JiaXinTang-xiang/nav_n10/docs/IMU转弯验收-2026-10-08.md

# 时间戳积分与左右转验收（2026-10-08）

## 本次修正

- C++ 底盘和 Nav2 `/spin` 共用 `wheeltec_chassis_cpp/gyro_yaw.hpp`：仅用 `angular_velocity.z` 与相邻消息 `header.stamp` 的差积分，不使用回调到达间隔积分，也不在异常后切回四元数。
- 独立 Python `/imu_spin` 使用相同规则。默认符号 `+1`，死区 `0.03 rad/s`，最大单步角增量 `0.25 rad`。
- 记录消息时间与单调接收时间，任一超过 `0.2 s` 都失效；未来超过 `20 ms`、非有限角速度、零/负时间戳无效。重复和乱序样本不积分、不刷新有效时间。
- 初次收到或间断后需连续两帧才就绪。转弯期间发生积分中断，即使下一周期前恢复也中止该目标、输出零，不自动重试。
- 底盘失去 IMU 时仍沿用轮编码器里程计回退，恢复时重新对齐偏置，避免四元数造成跳变。**这不是整车 IMU 故障急停联锁**；本次失效停车针对 `/spin` 和 `/imu_spin`。
- 非零旋转指令为 `±0.55～±0.60 rad/s`，允许 `0`。近目标脉冲为 `0.24 s` 周期、`0.08 s` 通电，控制频率 `30 Hz`；不会把零速度抬高到最低转速。
- 误差在 `0.045 rad`（约 `2.58°`）内，且陀螺角速度不超过 `0.05 rad/s` 持续 `0.3 s`，才报告完成。惯性越出容差后允许反向修正；超时停车。
- Nav2 插件保留碰撞检查，并检查旋转起始位姿。独立 `/imu_spin` **没有避障**，只能在清空的测试区域使用；脚本检测到 Nav2 或其他独立转弯节点时拒绝启动。
- 当前 Cartographer 导航启动文件不启用速度平滑器，`/spin` 直接输出 `/cmd_vel`。本次未修改键盘布局、串口协议或路径跟踪算法。

此前手动顺时针约 90° 的两次采样：IMU 四元数变化约 −34.44°，odom 变化约 −86.46°。这支持暂时保留 gyro 积分，但不是精密角度标定。gyro 有累计漂移，不能替代长期定位。

**边界：**IMU 消息时间戳仍由驱动生成，并非已实现飞控硬件时钟同步；odom/TF 仍以底盘接收时间发布。本修改不代表解决全部 Cartographer/DDS/TF 延迟问题。

## 已做的软件验证

- 已同步并在 Jetson 编译 `wheeltec_chassis_cpp`、`wheeltec_nav2`，没有在 PC 编译替代部署。
- 共享积分器：正负积分、回调抖动、重复、乱序、断流、过期、未来、NaN、死区通过。
- Jetson 上实际加载 Nav2 C++ `/spin` 插件，以合成 IMU、TF、空代价地图验证；也测试了 Python `/imu_spin`。
- 隔离方式：`ROS_DOMAIN_ID=93`、`ROS_LOCALHOST_ONLY=1`、速度重映射到 `/isolated_spin_cmd`；没有启动测试底盘、没有向实际 `/cmd_vel` 发运动命令。
- 两种实现的 ±90°、零角度、IMU 断流、重复、过期、NaN、取消和超时停车通过；非零输出均在 0.55～0.60 内。C++ 起点障碍拒绝运动、Python 并发目标拒绝通过。
- 合成理想运动复测误差约 1.3～2.3°，**不是实车停止精度**，不包含电机惯性、地面打滑或实际陀螺标定误差。
- 临时测试脚本与日志位于 Jetson `/tmp/verify_gyro_yaw.cpp`、`/tmp/verify_spin_ros.py`、`/tmp/spin_plugin.log`、`/tmp/spin_python.log`，重启可能清除。

## 实车测试（只在 Jetson，暂不开导航）

先关闭 Nav2、自动启动器、键盘控制和旧转弯测试终端；确认车已停止、周围空旷、急停可用。不要仅按 Ctrl+C 关闭 action 客户端来停车：客户端退出不保证取消目标。

### 终端 1：重新启动底盘与传感器，再启动独立转弯

```bash
cd ~/Desktop/nav_n10
source /opt/ros/humble/setup.bash
source ros2_ws/install/setup.bash
export ROS_DOMAIN_ID=0 ROS_LOCALHOST_ONLY=0
export RMW_IMPLEMENTATION=rmw_cyclonedds_cpp
export CYCLONEDDS_URI="file://$PWD/cyclonedds/cyclonedds-jetson.xml"
bash ./robot_bringup.sh
./imu_spin_bringup.sh
```

编译不替换已运行进程的代码，必须先停止所有运动控制再重启。此处不运行定位/导航启动脚本。

### 终端 2：环境与记录

```bash
cd ~/Desktop/nav_n10
source /opt/ros/humble/setup.bash
source ros2_ws/install/setup.bash
export ROS_DOMAIN_ID=0 ROS_LOCALHOST_ONLY=0
export RMW_IMPLEMENTATION=rmw_cyclonedds_cpp
export CYCLONEDDS_URI="file://$PWD/cyclonedds/cyclonedds-jetson.xml"
ros2 topic info /cmd_vel --verbose
```

确认只有 `imu_spin_controller` 一个速度发布节点。若出现键盘、Nav2 等其他发布者，先关闭，不能同时测试。

### 先左转 30°（单独执行）

```bash
ros2 action send_goal /imu_spin nav2_msgs/action/Spin \
  "{target_yaw: 0.523599, time_allowance: {sec: 10, nanosec: 0}}" --feedback
```

确认逆时针、最终 `SUCCEEDED`、完全停住，再单独执行右转：

```bash
ros2 action send_goal /imu_spin nav2_msgs/action/Spin \
  "{target_yaw: -0.523599, time_allowance: {sec: 10, nanosec: 0}}" --feedback
```

两边正常后，将角度分别改为 `1.570796`、`-1.570796` 测 ±90°，时间设为 15 秒；每次结束后确认停车再发下一次，各测三次，禁止连续粘贴多条运动命令。记录目标角、反馈角、日志最终误差、地面标记实际角，以及停车后 1 秒是否继续漂移。

### 取消当前测试（准备好另一个相同环境终端）

```bash
ros2 service call /imu_spin/_action/cancel_goal action_msgs/srv/CancelGoal \
  "{goal_info: {goal_id: {uuid: [0, 0, 0, 0, 0, 0, 0, 0, 0, 0, 0, 0, 0, 0, 0, 0]}, stamp: {sec: 0, nanosec: 0}}}"
```

该命令取消此服务器所有目标；网络异常或车不停止时直接使用硬件急停。

## 放行条件

左右方向正确、指令峰值 ≤0.60、停车后零输出，±90° 各三次实际停止误差建议 ≤3°，不持续漂移或往返振荡。日志积分误差合格但实际角不合格时，继续检查陀螺量纲、安装方向、标定和制动，不开放导航。

通过后关闭独立 `/imu_spin`，再在真实定位、TF、代价地图均正常且无导航目标时单独验收 Nav2 `/spin` 的左右转及碰撞停止；两者不能同时控制底盘。随后才运行 `cartographer_nav2_bringup.sh` 做短距离导航。

当前仍使用位置优先行为树，未启用自动末端转向。没有在本次部署后自动重启底盘或启动车辆；实车验收尚未完成。
