JiaXinTang-xiang/nav_n10/docs/AI交接-底盘直行与SLAM-2026-10-04.md

# 给下一位 AI：STM32 底盘直行控制与 SLAM 交接

更新时间：2026-10-04。本文反映当前工作区代码和本次会话结论。请先读本文，再读源码。

## 1. 用户目标与当前进度

项目根目录：`C:\Users\JXT\Desktop\F407VGT6(QiShi)`。

当前修改的是 `Telemetry framework` 下的 STM32F407 底盘工程，不是同仓库的 `firmware_chassis`，也不是 `firmware_fc`。

用户要让两轮底盘走直，后续用于 SLAM。相同 PWM 时左右电机实际轮速不同是正常现象，不能靠相同 PWM 保证走直。当前采用每轮编码器速度闭环，外加底盘板 ICM45686 的航向角 P 环，纠正直行。

用户反馈：独立的模式 6 角度直行测试已经“比之前直很多”“调得差不多了”。这是用户对模式 6 的实车反馈。最新接入正式上位机控制的版本还没有获得烧录后实车验证，不能把两个版本的验证结果混为一谈。

用户最新要求：正式上位机控制直行时，每段直行要从当时的当前角度开始锁定，不能一直使用某个固定航向。该要求已经实现并完成软件验证。

## 2. 必须保留的约束和用户偏好

- 上位机已经写好；本轮不修改 Jetson/ROS 代码，也不改串口协议。
- 使用底盘板自带 ICM45686 做直行纠偏，不把直行纠偏搬到上位机。
- 底盘轮速控制和航向控制先不要加 Ki。模式 6 和正式直行不增加角速度阻尼。
- 原有模式保留，新实验用独立模式，不要删除模式 2 或覆盖模式 3。
- 用户亲自调过参数，请读当前源码，保留其值，不要把历史初值改回来。
- 硬件实测 `Load(-20,-20)` 是前进。内部接口统一正值前进，只在 `Chassis_OutputRaw()` 中调用 `Load(-left,-right)` 翻转符号。
- 两轮编码器方向修正均为 `-1`，归一化后前进计数应为正。
- 保持 `firmware_fc` 和另一个 F407 提供 ROS IMU 的既有用途。底盘板本地航向控制与上位机 IMU 数据是两件事。
- 工作区中有用户调参和之前 AI 的未提交修改。不要 reset、回滚或覆盖这些修改；不要擅自提交、推送。
- 用中文说明调试方法，给具体观察项，不要只给泛泛的 PID 建议。

注意：“不要加 Ki”指本轮底盘控制器。原 IMU AHRS 内部有积分项，不能因此顺手把姿态算法的 Ki 删掉。

## 3. 主要文件和调用链

下面路径均相对于项目根目录：

| 文件 | 作用 |
|---|---|
| `Telemetry framework/Appliaction/Chassis_task.c/.h` | 左右轮控制、直行外环、里程计、测试模式、OLED |
| `Telemetry framework/Appliaction/Chassis_protocol.c/.h` | 上位机速度协议、超时停车、里程计发送 |
| `Telemetry framework/Appliaction/Timer_task.c` | TIM6 时基、200 Hz 底盘控制、50 Hz 里程计发送 |
| `Telemetry framework/Core/Src/main.c` | IMU 更新、按键切换模式、OLED 页面 |
| `Telemetry framework/Device/Hardware/encoder.c/.h` | 编码器捕获、方向归一化、距离换算 |
| `Telemetry framework/Device/IMU/ICM45686/IMU_45686.c/.h` | IMU 解算和发布 yaw/gz 供底盘读取 |
| `Telemetry framework/Algorithm/pid.c` | 工程原有 PID |
| `Telemetry framework/MDK-ARM/Telemetry framework.uvprojx` | Keil 工程 |

TIM6 为 100 us 时基，`Chassis_Update()` 每 5 ms 执行一次。该函数先调用 `Host_ApplyPendingCommand()`，再更新编码器反馈、航向误差、里程计和轮速输出。

主循环调用 `IMU_getYawPitchRoll(ypr)`；IMU 驱动发布最近的 yaw（度）和已扣零偏的 gz（rad/s）。底盘定时器中只调用 getter 读取缓存，不在中断中访问 IMU SPI。

## 4. 当前调好的参数：以源码为准

`Chassis_task.c` 当前值：

```cpp
static const fp32 s_pid_left_param[3]  = {70.0f, 0.0f, 5.0f};
static const fp32 s_pid_right_param[3] = {70.0f, 0.0f, 5.0f};
#define CHASSIS_LEFT_FF_PWM_PER_MPS   95.0f
#define CHASSIS_RIGHT_FF_PWM_PER_MPS  70.0f
#define CHASSIS_FF_STATIC_PWM          2.0f
#define CHASSIS_SPEED_LPF              0.1f
#define CHASSIS_ANGLE_YAW_SIGN        (-1.0f)
#define CHASSIS_ANGLE_KP                2.5f
#define CHASSIS_ANGLE_CORR_MAX          0.35f
#define CHASSIS_ANGLE_DEADBAND_DEG      0.30f
```

用户之前提过角度 Kp=2.0，现在源码是 2.5；不要按旧消息改回 2.0。轮速 Kp 现在是 70，不要照旧 `HANDOFF.md` 中的 100 恢复。

每轮速度控制为“独立前馈 + PD”，Ki=0：

```text
PWM = 该轮前馈系数 × 修正后的目标轮速
    + 目标方向 × 静摩擦前馈
    + PID_calc(反馈轮速, 修正后的目标轮速)
```

计算结果限制在 ±100 后转换为整数 PWM。

模式 3 的旧 gz 外环保留，参数为：Z_SIGN=+1，LPF=0.15，Kp=3.0，纠偏限幅 ±0.35 rad/s，死区 0.01 rad/s。这套参数不用于最新正式上位机直行。

`encoder.h` 当前机械参数：轮径 0.065 m，轮距 0.158 m，编码器 13 线，减速比 30，A 相双边沿 2 倍频，理论 780 count/轮子一圈。左右距离修正系数 `ENC_LEFT_DISTANCE_SCALE`、`ENC_RIGHT_DISTANCE_SCALE` 目前均为 1.0000，通过 `Encoder_GetMetersPerCount(id)` 同时用于速度和里程计。

## 5. 航向角直行怎么纠偏

航向角统一成逆时针为正。原 AHRS yaw 的输出带负号，因此使用当前 `CHASSIS_ANGLE_YAW_SIGN=-1` 转换；最终符号以实车左转时显示的当前角 N 增大为判据。

```text
now  = WrapPi(YAW_SIGN × IMU_GetYawDeg() × pi/180)
error = WrapPi(reference - now)
corr_w = clamp(Kp × error, -0.35, +0.35)  // rad/s
```

误差绝对值 ≤0.30° 时纠偏量为 0。

```text
左轮控制目标 = 原左轮目标 - 轮距/2 × corr_w
右轮控制目标 = 原右轮目标 + 轮距/2 × corr_w
```

例如车体向左偏，当前角增大，误差为负，纠偏角速度为负，左轮目标相对增加、右轮目标相对减小，产生向右纠偏。不要把这一关系解释反了。

`WrapPi` 处理 ±180° 跨界，取最短角度差。此环保持朝向，不能消除已经发生的横向位移；六轴 IMU 的 yaw 也会随时间漂移，不能宣称具有绝对航向或无限时长直线保证。

## 6. 最新完成：正式上位机每段直行锁当前角

入口为 `Chassis_SetTwist(v_mps,w_radps)`。状态为 `s_angle_hold_en`、`s_host_straight_dir`（0 无正式直行段，+1 前进，-1 后退），参考角为 `s_angle_ref_rad`。

判定直行：`abs(v)>=0.001 m/s` 且 `abs(w)<0.0005 rad/s`。串口角速度的分辨率是 0.001 rad/s，所以协议中任何非零角速度都退出直行锁角，避免吞掉导航控制器的小转向。

| 场景 | 当前行为 |
|---|---|
| 新的一段直行 | 捕获当时 IMU yaw 为参考角 |
| 持续重复发送直行指令 | 保留原参考角，不每帧重置 |
| 同方向直行改变线速度 | 保留原参考角 |
| 非零角速度，包括很小的转向 | 关闭角度环和旧 gz 外环，执行上位机差速指令 |
| 零速度零角速度 | `Chassis_Stop()`，清除锁角状态 |
| 250 ms 通信超时 | 停车并清除锁角状态 |
| 直行前后换向 | 重新捕获当前角 |
| 转弯或停车后再次直行 | 重新捕获当前角 |
| 模式 6 切到正式直行 | 正式指令重新捕获，不沿用测试参考角 |

实现注意：`Chassis_SetWheelSpeed()` 会清除角度状态，因此 `SetTwist()` 在调用它之前保存是否需要保留参考角，调用后恢复正式直行状态。不能删掉这一步导致持续直行每次都重锁角。

`Chassis_Stop()`、`Chassis_Brake()`、开环 PWM 接口均清除正式直行状态。正式 `SetTwist` 全程不使用模式 3 的 gz 阻尼。

## 7. 测试模式与 OLED

USERKEY 短按按 0→1→2→3→4→5→6→0 切换，共七个模式。

| 模式 | 当前作用 |
|---|---|
| 0 | 默认编码器/里程计显示；正式角度锁定活动时改显示 AH 航向页 |
| 1 | 开环，等效底层 `Load(-20,-20)` |
| 2 | 两轮目标 0.2 m/s，仅编码器速度环，明确关闭 IMU 外环 |
| 3 | 两轮目标 0.2 m/s，保留旧 gz 纠偏用于对比 |
| 4 | 原有编码器电气自检，主动操作编码器引脚 |
| 5 | gz、滤波值、旧 gz 纠偏量、旧外环使能显示 |
| 6 | 独立角度直行测试，启动时捕获 yaw，目标 0.2 m/s |

模式 1/2/3/6 会驱动电机，切离这些模式调用 `Chassis_TestStop()`。

角度页第一行：模式 6 为 `A6 T/N:目标,当前`；正式直行为 `AH T/N:目标,当前`。角度整数除以 10 得到度。

第二行 `E/C`：误差除以 10 为度，纠偏量 C 除以 1000 为 rad/s。第三行 `act` 为滤波后的左右实际轮速 mm/s；第四行为归一化 PWM。

OLED 各页面画图前调用 `OLED_operate_gram(PEN_CLEAR)` 清 framebuffer，再画完整页，最后一次 `OLED_refresh_gram()`，解决前一页面字符残留。不要再改成先清屏刷新、再画再刷新造成闪烁。MicroLIB 不支持这里的 `%f`，显示用缩放整数。

模式 5 写着 raw gz，但 getter 实际发布的是扣过零偏的 gz，不是传感器原始量。

正式控制调试保持模式 0；按键测试与上位机指令没有新增仲裁，上位机指令仍能覆盖本地测试。不要同时运行本地电机测试和上位机运动控制后据此判断 PID。

## 8. 串口协议保持不变

USART2 PD5/PD6，115200。速度帧 7 字节：

```text
BB v_hi v_lo w_hi w_lo checksum 55
```

v、w 均为有符号 int16 大端，单位分别 mm/s、mrad/s；checksum 为第 1～4 数据字节求和取低 8 位。合法帧通过缓存由 200 Hz 底盘任务应用，250 ms 无合法速度帧自动停车。

里程计 50 Hz 发 15 字节：`CC` + x_mm/y_mm/theta_rad 三个 float32 小端 + 数据字节求和校验 + `55`。

最新改动没有修改协议，也没有把 IMU yaw 塞进里程计 theta；当前 theta 仍由编码器差速积分产生。

## 9. 已做验证与尚未验证的界限

已通过：

- ARM GCC 工具链以 C++、Cortex-M4 硬浮点配置对 `Chassis_task.c`、`Chassis_protocol.c`、`main.c`、`IMU_45686.c` 做语法检查。
- 从当前生产源码提取函数，使用主机 g++ 临时测试协议及状态切换：重复直行、同方向变速、停车、转弯、前后换向、250 ms 超时、测试模式进入正式控制、刹车和开环清状态。
- 同一临时测试验证角度纠偏正负号、±180° 跨界、死区、纠偏限幅，以及模式 2/3/6 外环互相独立。
- `git diff --check` 通过。

已有 `M_PI`、`__FILE_NAME__` 宏重复定义警告；此次语法检查无错误。没有执行完整 Keil 链接，没有烧录，也没有替用户完成地面 SLAM 验证。

工具位置：

```text
E:\STM32_Tools\ST\STM32CubeCLT_1.18.0\GNU-tools-for-STM32\bin\arm-none-eabi-g++.exe
E:\sofa\mingw\bin\g++.exe
```

工程 `.c` 在现有 Keil 配置中按 C++ 编译，验证时不要误用纯 C 模式。临时主机测试为 `%TEMP%\chassis_host_heading_test.cpp/.exe`；跨平台交接时不假设这些临时文件存在。

## 10. 下一步优先级

1. 请用户重新编译烧录最新正式控制版本，在模式 0 下用上位机执行直行→停车→转 90°→再次直行。观察第一段 T 固定，后一段 T 捕获转弯后的当前角。验证持续变速不重锁角、倒车重新锁角，以及停止发包超时停车。
2. 三角函数近似已修复；烧录后继续做前进、后退和转角标定，确认转弯后的坐标积分。
3. 实测前进/后退 1～2 m，对比编码器左右距离和里程计；标定轮周长/左右距离系数。以源码及新测量为准，不要把旧文档中历史测量当成本次验证。
4. 实测左右旋转 90°、180°，检查角度符号与有效轮距。检查转弯后直走，x/y 是否符合方向。360° 应累计展开角度或积分增量，当前 theta 会 WrapPi，不能拿最后的 theta=0 就宣称转满一圈的精度正确。
5. 通过后低速跑 SLAM，检查墙面重影、转弯后对齐、闭环后的地图形状。保持现有上位机架构，定位问题后再决定是否需要改代码。

建议先维持已经调好的 Kp；不要用继续增大角度 Kp 去掩盖编码器标定或里程计数学错误。走直只验证了部分底盘行为，并不等于已经满足 SLAM 的全部要求。

## 11. 待核查问题

### 已修复：里程计三角函数近似

`Chassis_task.c` 的 `SinCosApprox()` 原公式中：

```cpp
num = x * (CHASSIS_PI - x);
*s = sgn * (4.0f * num) / (CHASSIS_PI * CHASSIS_PI + num);
*c = (CHASSIS_PI * CHASSIS_PI - 4.0f * num)
     / (CHASSIS_PI * CHASSIS_PI + num);
```

当角度为 pi 时，num=0，算出 cos=+1，实际应为 -1；当前公式无法得到正确的负 cos。sin 公式也不是正确的 Bhaskara I 表达式，pi/2 时算得 0.8，而实际为 1。源码“误差 <0.2%”的注释不能相信。

这意味着直线朝向 0 时可能看似正常，转弯后 x/y 明显错误。该函数现已改为正确的 Bhaskara I 正弦近似，并通过象限对称关系计算余弦，不依赖 `libm`。烧录后仍需用 0、±pi/2、pi 和整圈运动做实车里程计验证。

### 编码器 A 相捕获解码仍需核查

只在 A 相双边沿触发中断，但 `Encoder_CaptureIRQ()` 当前用相邻 AB 四状态转换判断方向。A 相两次中断之间 B 相也可能变化，不能直接套用每个 AB 边沿均采样的假设。需要结合波形和手转轮子计数验证；本轮没有重新设计解码。

`Encoder_TakeIsrCount()` 目前取走并清零的是 `s_raw_count`，不是独立边沿计数器，可能污染正常里程计增量。现有活动页面未调用 `Chassis_DebugDisplayIsr()`，不要未修这个问题就把该诊断页接回运行路径。

### IMU 零偏和采样时序

当前零偏更新根据 gyro 低方差和计数条件判断，恒定转动也可能低方差，可能误当静止并更新偏置。若转弯或长时间运行后 yaw 异常，检查这里。

IMU 解算在包含 OLED 刷新的主循环内，尚无独立固定采样调度、数据新鲜度检测或故障退出锁角逻辑。若角度更新慢或数据卡住，需要测采样周期和 OLED 开销，不能仅依据底盘控制任务 200 Hz 就认为 IMU 也在 200 Hz 更新。

上述后两类是需要定位的风险，不是本次实车证实的新故障。不要不看数据就大范围重构。

## 12. 文档冲突与接手提醒

根目录旧 `HANDOFF.md` 仍有架构与历史调试资料，但其中“当前参数”“全部验证通过”“底盘 IMU 不参与”等文字已经不能代表最新状态。阅读顺序：当前源码 → 本文 → 旧文档。

接手后先检查 `git status` 和当前参数。用户这轮只是让生成交接说明，未请求继续修复第 11 节问题；如果用户要求继续推进 SLAM，再根据这些线索开展工作。

可以直接向用户说明：最新完成了正式直行按段锁当前航向，软件测试通过，下一步烧录验证控制切换，再修/核查里程计数学并做距离、转角标定。不要宣称已经完成 SLAM 实车验证。
