JiaXinTang-xiang/nav_n10/firmware_fc/ANO_LX_FC_ROS/Doc/note.txt

APB1   42m
APB2   84m

TIMx clk = APBx *2

中断优先级：

第0组：所有4位用于指定响应优先级；
第1组：最高1位用于指定抢占式优先级，最低3位用于指定响应优先级；
第2组：最高2位用于指定抢占式优先级，最低2位用于指定响应优先级；
第3组：最高3位用于指定抢占式优先级，最低1位用于指定响应优先级；
第4组：所有4位用于指定抢占式优先级。
|先抢占，再响应|
1）如果指定的抢占式优先级别或响应优先级别超出了选定的优先级分组所限定的范围，将可能得到意想不到的结果；
2）抢占式优先级别相同的中断源之间没有嵌套关系；
3）如果某个中断源被指定为某个抢占式优先级别，又没有其它中断源处于同一个抢占式优先级别，则可以为这个中断源指定任意有效的响应优先级别。

更新记录：
20250427  调整代码结构 
          添加PWM5 6 7 8 初始化控制舵机代码
          验证PWM控制电机成功
          在Drv_AnoOF.c文件中可以选择使用V3或V4版本

20250429  添加PID控制（未验证）
