JiaXinTang-xiang/nav_n10/example/ROS_SLAM/IMU_STL/陀螺仪转接件.STL

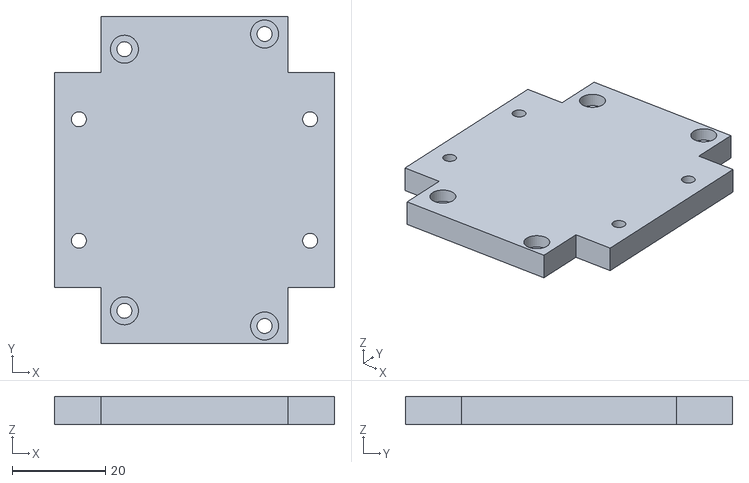
[picture p10: CAD file, 2026-10-04]
example/ROS_SLAM/IMU_STL/陀螺仪转接件.STL
60.0 x 70.0 x 6.00
