JiaXinTang-xiang/nav_n10/example/ROS_SLAM/urdf_mac_ws/src/urdf_show/meshes/imu_Link.STL

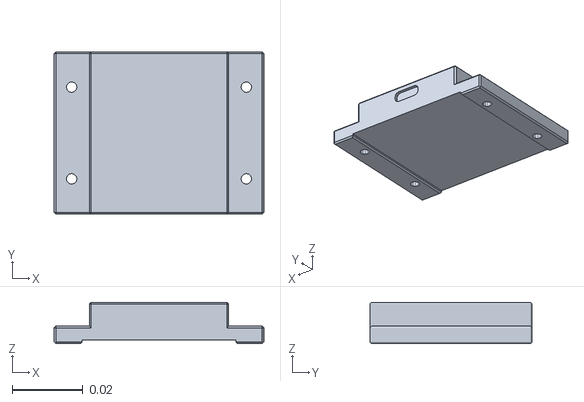
[picture p11: CAD file, 2026-10-04]
example/ROS_SLAM/urdf_mac_ws/src/urdf_show/meshes/imu_Link.STL
0.0595 x 0.046 x 0.0117
