JiaXinTang-xiang/nav_n10/example/ROS_SLAM/urdf_mac_ws/src/urdf_show/meshes/wheel_lf_Link.STL

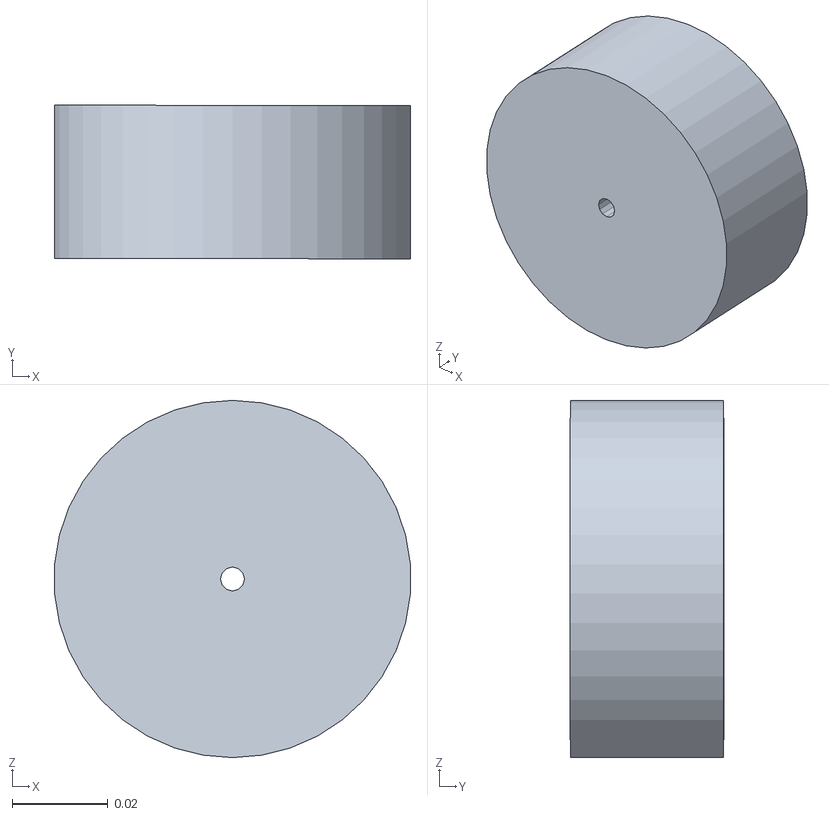
[picture p12: CAD file, 2026-10-04]
example/ROS_SLAM/urdf_mac_ws/src/urdf_show/meshes/wheel_lf_Link.STL
0.0742 x 0.032 x 0.0745
