JiaXinTang-xiang/nav_n10/example/ROS_SLAM/urdf_mac_ws/src/urdf_show/meshes/lidar_Link.STL

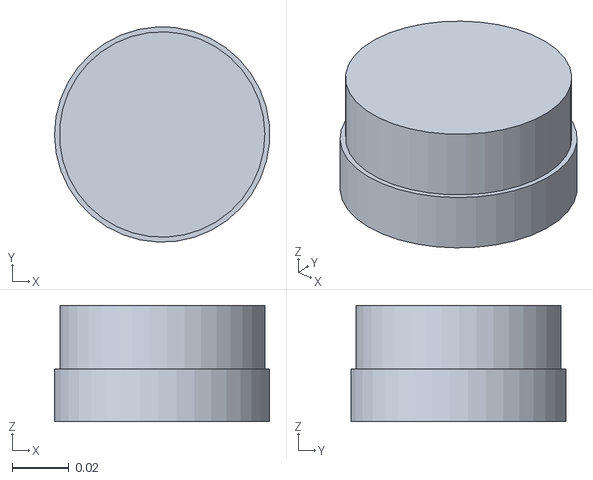
[picture p13: CAD file, 2026-10-04]
example/ROS_SLAM/urdf_mac_ws/src/urdf_show/meshes/lidar_Link.STL
0.0759 x 0.0759 x 0.041
