JiaXinTang-xiang/nav_n10/example/ROS_SLAM/urdf_mac_ws/src/urdf_show/meshes/base_link.STL

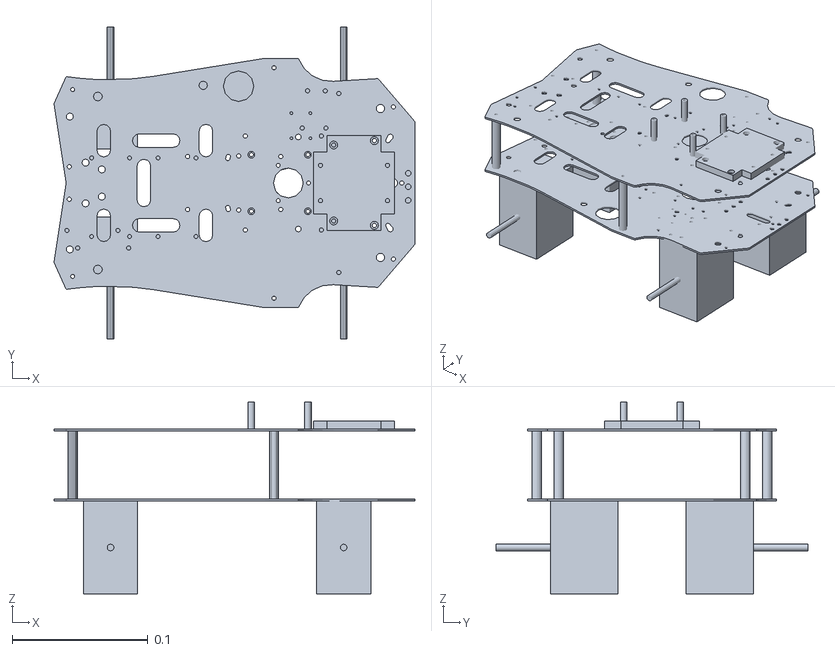
[picture p14: CAD file, 2026-10-04]
example/ROS_SLAM/urdf_mac_ws/src/urdf_show/meshes/base_link.STL
0.266 x 0.23 x 0.142
