JiaXinTang-xiang/nav_n10/(list of files, cad)

Other CAD files:
example/ROS_SLAM/urdf_mac_ws/src/urdf_show/meshes/wheel_rf_Link.STL
example/ROS_SLAM/urdf_mac_ws/src/urdf_show/meshes/wheel_rb_Link.STL
example/ROS_SLAM/urdf_mac_ws/src/urdf_show/meshes/wheel_lb_Link.STL
