JiaXinTang-xiang/nav_n10/example/ros2-stm32-autonomous-robot/ros2_ws/slam_results/cartographer_lidar_slam_0.png

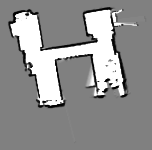
example/ros2-stm32-autonomous-robot/ros2_ws/slam_results/cartographer_lidar_slam_0.png
