JiaXinTang-xiang/nav_n10/Telemetry framework/Core/Src/main.c

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
/* Includes ------------------------------------------------------------------*/
#include "main.h"
#include "can.h"
#include "dma.h"
#include "i2c.h"
#include "spi.h"
#include "tim.h"
#include "usart.h"
#include "gpio.h"

/* USER CODE BEGIN Includes */
#include "bsp.h"
#include "Chassis_task.h"
/* USER CODE END Includes */


void SystemClock_Config(void);
/* USER CODE BEGIN 0 */
bool init_finished = 0;
float ypr[3];
/* USER CODE END 0 */

/**
  * @brief  The application entry point.
  * @retval int
  */
int main(void)
{

  /* MCU Configuration--------------------------------------------------------*/

  /* Reset of all peripherals, Initializes the Flash interface and the Systick. */
  HAL_Init();

  /* Configure the system clock */
  SystemClock_Config();

  /* Initialize all configured peripherals */
  MX_GPIO_Init();
  MX_DMA_Init();
  MX_USART1_UART_Init();
  MX_SPI3_Init();
  MX_TIM6_Init();
  MX_SPI2_Init();
  MX_CAN2_Init();
  MX_USART2_UART_Init();
  MX_UART4_Init();
  MX_USART6_UART_Init();
  MX_I2C2_Init();
  MX_TIM1_Init();
  MX_TIM2_Init();
  MX_TIM3_Init();
  MX_TIM4_Init();
  /* USER CODE BEGIN 2 */
  TB6612_Init();
  delay_init();
  IMU_init();
  OLED_init();
  Servo_Init();
  Relay_Init();
  SPI_IMU_CS(1);
  delay_ms(100);
  UART_Init(&huart2, UART_Host_Call_Back, UART_BUFFER_SIZE);   /* USART2 = 底盘协议 (Jetson) */
  UART_Init(&huart4, UART_WireLess_Call_Back, UART_BUFFER_SIZE);
  RGB_Control(0,0,0);
  IMU_Ctrl_Init();
  Chassis_Init();          /* 编码器(TIM1/TIM2 输入捕获) + 速度环 PID */
  init_finished = 1;
  
  
  
  /* USER CODE END 2 */

  /* Infinite loop */
  /* USER CODE BEGIN WHILE */
  while (1)
  {
	
	  IMU_getYawPitchRoll(ypr);
//	  debug_printf("\tangle:%.2f\t%.2f\t%.2f\r\n", ypr[0], ypr[1], ypr[2]);

	  /* ============ 底盘调试: 按 USERKEY 循环切换八个模式 ============
	     模式 0  标定显示 : 手推车看计数/轮速/距离/里程计
	     模式 1  开环基准 : Load(-20,-20) 那个 PWM, 看 act 是多少
	     模式 2  速度环   : 两轮闭环跑 0.2 m/s, 看 act 跟不跟得住 tgt
	     模式 3  低速陀螺仪直行: 等效 Load(-20,-20)，但启用闭环纠偏
	     模式 4  编码器自检: 期望约 400,400（200 次翻转的边沿总数）
	     模式 5  陀螺仪数据显示: gz 和修正量
	     模式 6  角度锁定直行: 锁定启动 yaw，显示 T/N、E/C、act、pwm
	     模式 7  编码器边沿诊断: 不动车，显示 ISR Hz / cnt / distance / odom
	     模式 1/2/3/6 会动车；切走自动停车，直行效果在平地低速验证。
	     ============================================================== */
	  {
		  static uint8_t mode = 0;
		  uint8_t key_num = Key_GetNum();

		  /* 电机测试运行时长按：立即停车，回模式 0，并保留最终计数。
		     其余页面长按：进入模式 7 并清零，供手推/编码器测试。 */
		  if (key_num == USERKEY_LONG) {
			  if ((mode == 1u) || (mode == 2u) || (mode == 3u) || (mode == 6u)) {
				  Chassis_TestStop();
				  mode = 0u;
			  } else {
				  mode = 7u;
				  Chassis_DebugResetIsr();
			  }
		  } else if (key_num == USERKEY_SHORT) {
			  /* 离开任何会转的模式前, 先停车 */
			  if ((mode == 1u) || (mode == 2u) || (mode == 3u) || (mode == 6u)) {
				  Chassis_TestStop();
			  }

			  mode = (uint8_t)((mode + 1u) % 8u);

			  if (mode == 1u) {
				  Chassis_TestOpenLoopStart();   /* 开环 PWM=20 基准 */
			  } else if (mode == 2u) {
				  Chassis_TestSpeedStart();      /* 闭环 0.2 m/s */
			  } else if (mode == 3u) {
				  Chassis_TestGyroStraightStart();
			  } else if (mode == 4u) {
				  Chassis_SelfTest();            /* 编码器通路自检 */
			  } else if (mode == 6u) {
				  Chassis_TestAngleStraightStart();
			  } else if (mode == 7u) {
				  Chassis_DebugResetIsr();
			  }
		  }

		  switch (mode) {
		  case 1u:
		  case 2u:
		  case 3u:
			  Chassis_DebugDisplaySpeedTest();
			  break;
		  case 4u:
			  Chassis_DebugDisplaySelfTest();
			  break;
		  case 5u:
			  Chassis_DebugDisplayGyro();
			  break;
		  case 6u:
			  Chassis_DebugDisplayAngleTest();
			  break;
		  case 7u:
			  Chassis_DebugDisplayIsr();
			  break;
		  default:
			  if (Chassis_IsAngleHoldEnabled() != 0u) {
				  Chassis_DebugDisplayAngleTest(); /* 正式直行显示 AH T/N */
			  } else {
				  Chassis_DebugDisplay();
			  }
			  break;
		  }
	  }

    /* USER CODE END WHILE */
 
    /* USER CODE BEGIN 3 */
  }
  /* USER CODE END 3 */
}

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
