JiaXinTang-xiang/nav_n10/Telemetry framework/Telemetry framework.ioc

Mcu.UserName=STM32F407VGTx
PA0-WKUP.Signal=UART4_TX
PA1.Signal=UART4_RX
PA10.Signal=USART1_RX
PA15.GPIO_Label=SPI_FLASH_CS
PA15.Signal=GPIO_Output
PA4.GPIO_Label=IO4
PA4.Signal=GPIO_Output
PA5.GPIO_Label=LLL
PA5.Signal=GPIO_Input
PA6.GPIO_Label=LL
PA6.Signal=GPIO_Input
PA9.Signal=USART1_TX
PB0.GPIO_Label=RED
PB0.Signal=GPIO_Output
PB1.GPIO_Label=PWMB
PB1.Signal=S_TIM3_CH4
PB10.GPIO_Label=OLED_SCL
PB10.Signal=I2C2_SCL
PB11.GPIO_Label=OLED_SDA
PB11.Signal=I2C2_SDA
PB12.GPIO_Label=SPI_IMU_CS
PB12.Signal=GPIO_Output
PB13.Signal=SPI2_SCK
PB14.Signal=SPI2_MISO
PB15.Signal=SPI2_MOSI
PB2.GPIO_Label=LED2
PB2.Signal=GPIO_Output
PB4.GPIO_Label=PWMA
PB4.Signal=S_TIM3_CH1
PB5.Signal=CAN2_RX
PB6.Signal=CAN2_TX
PB7.GPIO_Label=IO3
PB7.Signal=GPIO_Output
PB8.GPIO_Label=LED1
PB8.Signal=GPIO_Output
PC0.GPIO_Label=L
PC0.Signal=GPIO_Input
PC1.GPIO_Label=ML
PC1.Signal=GPIO_Input
PC10.GPIO_Label=OLED_D0
PC10.Signal=SPI3_SCK
PC11.GPIO_Label=OLED_DC
PC11.Signal=GPIO_Output
PC12.GPIO_Label=OLED_D1
PC12.Signal=SPI3_MOSI
PC13-ANTI_TAMP.GPIO_Label=USER_KEY
PC13-ANTI_TAMP.Signal=GPXTI13
PC14-OSC32_IN.Signal=RCC_OSC32_IN
PC15-OSC32_OUT.Signal=RCC_OSC32_OUT
PC2.GPIO_Label=MR
PC2.Signal=GPIO_Input
PC3.GPIO_Label=R
PC3.Signal=GPIO_Input
PC4.GPIO_Label=RR
PC4.Signal=GPIO_Input
PC5.GPIO_Label=RRR
PC5.Signal=GPIO_Input
PC6.Signal=USART6_TX
PC7.Signal=USART6_RX
PC9.GPIO_Label=RGB
PC9.Signal=GPIO_Output
PD0.GPIO_Label=OLED_RES
PD0.Signal=GPIO_Output
PD1.GPIO_Label=OLED_CS
PD1.Signal=GPIO_Output
PD10.GPIO_Label=BUZZER
PD10.Signal=GPIO_Output
PD12.GPIO_Label=SG901
PD12.Signal=S_TIM4_CH1
PD13.GPIO_Label=SG902
PD13.Signal=S_TIM4_CH2
PD14.GPIO_Label=SG903
PD14.Signal=S_TIM4_CH3
PD15.GPIO_Label=SG904
PD15.Signal=S_TIM4_CH4
PD5.Signal=USART2_TX
PD6.Signal=USART2_RX
PD8.GPIO_Label=BIN1
PD8.Signal=GPIO_Output
PD9.GPIO_Label=BIIN2
PD9.Signal=GPIO_Output
PE0.GPIO_Label=KEY1
PE0.Signal=GPIO_Input
PE10.GPIO_Label=BLUE
PE10.Signal=GPIO_Output
PE14.GPIO_Label=AIN1
PE14.Signal=GPIO_Output
PE15.GPIO_Label=AIN2
PE15.Signal=GPIO_Output
PE2.GPIO_Label=KEY2
PE2.Signal=GPIO_Input
PE5.GPIO_Label=IO1
PE5.Signal=GPIO_Output
PE6.GPIO_Label=IO2
PE6.Signal=GPIO_Output
PE7.GPIO_Label=KEY3
PE7.Signal=GPIO_Input
PE8.GPIO_Label=GREEN
PE8.Signal=GPIO_Output
PH0-OSC_IN.Signal=RCC_OSC_IN
PH1-OSC_OUT.Signal=RCC_OSC_OUT
