JiaXinTang-xiang/nav_n10/ros2_ws/src/wheeltec_chassis/wheeltec_chassis/chassis_bridge.py

#!/usr/bin/env python3
"""
chassis_bridge.py — 底盘串口桥接节点

STM32F103 (USART1, 115200bps, 8N1):
  PC → MCU: 0xBB + v_linear(int16 BE, mm/s) + v_angular(int16 BE, mrad/s) + cksum + 0x55
  MCU → PC: 0xCC + x(float LE, mm) + y(float LE, mm) + theta(float LE, rad) + cksum + 0x55

功能:
  1. 收 MCU 里程计 → 发布 /odom + 广播 odom→base_link TF
  2. 订阅 /cmd_vel → 转 0xBB 帧发给 MCU
"""

import struct
import math
import sys

import rclpy
from rclpy.node import Node
from rclpy.qos import QoSProfile, ReliabilityPolicy
from nav_msgs.msg import Odometry
from geometry_msgs.msg import TransformStamped, Twist, Quaternion
from sensor_msgs.msg import Imu
from std_msgs.msg import Int64MultiArray
from tf2_ros import TransformBroadcaster


# ─── 协议常亮 ─────────────────────────────────────────────────────────
HEADER_CMD  = 0xBB   # PC → MCU 速度指令
HEADER_ODOM = 0xCC   # MCU → PC 里程计回传
HEADER_ODOM_V2 = 0xCD  # MCU → PC 里程计 + MCU时间戳 + 左右累计计数
FOOTER      = 0x55


class ChassisBridge(Node):
    """底盘串口桥接节点"""

    def __init__(self):
        super().__init__('chassis_bridge')

        # 声明参数
        self.declare_parameter('serial_port', '/dev/ttyUSB1')
        self.declare_parameter('serial_baud', 115200)
        self.declare_parameter('odom_frame', 'odom')
        self.declare_parameter('base_frame', 'base_link')
        self.declare_parameter('publish_tf', True)
        self.declare_parameter('serial_poll_rate_hz', 100.0)
        self.declare_parameter('command_rate_hz', 20.0)
        self.declare_parameter('command_timeout_sec', 0.5)
        self.declare_parameter('left_meters_per_count', 0.0002617994)
        self.declare_parameter('right_meters_per_count', 0.0002617994)
        self.declare_parameter('wheel_separation', 0.1431)
        self.declare_parameter('integrate_odom_from_wheel_counts', True)
        self.declare_parameter('use_imu_yaw', True)
        self.declare_parameter('imu_topic', '/imu/data')
        self.declare_parameter('imu_yaw_sign', 1.0)
        self.declare_parameter('imu_timeout_sec', 0.2)
        self.declare_parameter('imu_max_delta_rad', 0.25)
        self.declare_parameter('imu_gyro_fallback', True)
        self.declare_parameter('imu_force_gyro_yaw', True)
        self.declare_parameter('imu_gyro_deadband_rad_s', 0.03)
        self.declare_parameter('imu_quaternion_stall_delta_rad', 1e-5)

        port = self.get_parameter('serial_port').value
        baud = self.get_parameter('serial_baud').value
        self._odom_frame = self.get_parameter('odom_frame').value
        self._base_frame = self.get_parameter('base_frame').value
        self._publish_tf = self.get_parameter('publish_tf').value
        serial_poll_rate_hz = float(
            self.get_parameter('serial_poll_rate_hz').value)
        command_rate_hz = float(self.get_parameter('command_rate_hz').value)
        self._command_timeout_sec = float(
            self.get_parameter('command_timeout_sec').value)
        self._left_mpc = float(self.get_parameter('left_meters_per_count').value)
        self._right_mpc = float(self.get_parameter('right_meters_per_count').value)
        self._wheel_separation = float(self.get_parameter('wheel_separation').value)
        self._integrate_from_counts = bool(
            self.get_parameter('integrate_odom_from_wheel_counts').value)
        self._use_imu_yaw = bool(
            self.get_parameter('use_imu_yaw').value)
        imu_topic = self.get_parameter('imu_topic').value
        self._imu_yaw_sign = float(self.get_parameter('imu_yaw_sign').value)
        self._imu_timeout_sec = float(
            self.get_parameter('imu_timeout_sec').value)
        self._imu_max_delta_rad = float(
            self.get_parameter('imu_max_delta_rad').value)
        self._imu_gyro_fallback = bool(
            self.get_parameter('imu_gyro_fallback').value)
        self._imu_force_gyro_yaw = bool(
            self.get_parameter('imu_force_gyro_yaw').value)
        self._imu_gyro_deadband = float(
            self.get_parameter('imu_gyro_deadband_rad_s').value)
        self._imu_quaternion_stall_delta = float(
            self.get_parameter('imu_quaternion_stall_delta_rad').value)

        if serial_poll_rate_hz <= 0.0:
            raise ValueError('serial_poll_rate_hz must be greater than zero')
        if command_rate_hz <= 0.0:
            raise ValueError('command_rate_hz must be greater than zero')
        if self._command_timeout_sec <= 0.0:
            raise ValueError('command_timeout_sec must be greater than zero')
        if self._left_mpc <= 0.0 or self._right_mpc <= 0.0:
            raise ValueError('meters_per_count must be greater than zero')
        if self._wheel_separation <= 0.0:
            raise ValueError('wheel_separation must be greater than zero')
        if self._imu_yaw_sign == 0.0:
            raise ValueError('imu_yaw_sign must not be zero')
        if self._imu_timeout_sec <= 0.0:
            raise ValueError('imu_timeout_sec must be greater than zero')
        if self._imu_max_delta_rad <= 0.0:
            raise ValueError('imu_max_delta_rad must be greater than zero')
        if self._imu_gyro_deadband < 0.0:
            raise ValueError('imu_gyro_deadband_rad_s must not be negative')
        if self._imu_quaternion_stall_delta < 0.0:
            raise ValueError(
                'imu_quaternion_stall_delta_rad must not be negative')

        # 串口
        self._open_serial(port, baud)

        # 发布者
        self._odom_pub = self.create_publisher(Odometry, '/odom', 50)
        self._wheel_counts_pub = self.create_publisher(
            Int64MultiArray, '/wheel_counts', 50)

        # TF 广播
        self._tf_broadcaster = (
            TransformBroadcaster(self) if self._publish_tf else None)

        # 订阅 /cmd_vel
        self._cmd_sub = self.create_subscription(
            Twist, '/cmd_vel', self._cmd_vel_cb, 10)
        imu_qos = QoSProfile(
            depth=1,
            reliability=ReliabilityPolicy.BEST_EFFORT)
        self._imu_sub = self.create_subscription(
            Imu, imu_topic, self._imu_cb, imu_qos)

        self._target_linear = 0.0
        self._target_angular = 0.0
        self._last_cmd_time = None
        self._cmd_timer = self.create_timer(
            1.0 / command_rate_hz, self._send_current_command)

        # 定时器轮询串口
        self._timer = self.create_timer(1.0 / serial_poll_rate_hz, self._poll)

        # 接收状态机
        self._rx_buf = bytearray(64)
        self._rx_idx = 0
        self._rx_state = 0       # 0=wait header, 1=receiving
        self._rx_expect_len = 0

        # 里程计累计（从 MCU 收到的绝对位姿）
        self._odom_x = 0.0
        self._odom_y = 0.0
        self._odom_theta = 0.0
        self._last_wheel_sample = None
        self._last_sequence = None
        self._last_imu_raw_yaw = None
        self._imu_unwrapped_yaw = None
        self._last_imu_time = None
        self._imu_odom_offset = None
        self._using_gyro_fallback = False

        self.get_logger().info(
            f'底盘串口已打开: {port} @ {baud} bps; '
            f'串口轮询: {serial_poll_rate_hz:.0f} Hz; '
            f'IMU直接航向: {self._use_imu_yaw}; '
            f'固定gyro_z航向: {self._imu_force_gyro_yaw}')

    # ─── 串口 ──────────────────────────────────────────────────────

    def _open_serial(self, port: str, baud: int):
        try:
            import serial
        except ImportError:
            self.get_logger().fatal('pyserial 未安装: pip install pyserial')
            sys.exit(1)

        try:
            self._serial = serial.Serial(
                port=port, baudrate=baud,
                bytesize=serial.EIGHTBITS,
                parity=serial.PARITY_NONE,
                stopbits=serial.STOPBITS_ONE,
                timeout=0.001,
            )
        except serial.SerialException as e:
            self.get_logger().fatal(f'无法打开串口 {port}: {e}')
            sys.exit(1)

    # ─── 接收：MCU → PC (0xCC 里程计) ──────────────────────────────

    def _poll(self):
        """定时轮询串口"""
        try:
            n = self._serial.in_waiting
            if n > 0:
                self._feed(self._serial.read(n))
        except Exception:
            pass

    def _feed(self, data: bytes):
        """喂入字节流，状态机解析"""
        for byte in data:
            if self._rx_state == 0:           # 等待帧头
                if byte in (HEADER_ODOM, HEADER_ODOM_V2):
                    self._rx_buf[0] = byte
                    self._rx_idx = 1
                    self._rx_expect_len = 15 if byte == HEADER_ODOM else 30
                    self._rx_state = 1
                # 非 0xCC/0xCD 里程计帧头字节忽略
            elif self._rx_state == 1:          # 收数据
                if self._rx_idx < self._rx_expect_len:
                    self._rx_buf[self._rx_idx] = byte
                    self._rx_idx += 1

                if self._rx_idx >= self._rx_expect_len:
                    self._rx_state = 0
                    if self._rx_buf[self._rx_expect_len - 1] == FOOTER:
                        self._decode_odom(self._rx_buf[0])

    def _imu_cb(self, msg: Imu):
        """将飞控四元数航向解包成连续 yaw，供里程计直接使用。"""
        q = msg.orientation
        norm = math.sqrt(q.x * q.x + q.y * q.y + q.z * q.z + q.w * q.w)
        if norm < 0.5:
            return

        yaw = math.atan2(
            2.0 * (q.w * q.z + q.x * q.y),
            1.0 - 2.0 * (q.y * q.y + q.z * q.z))
        yaw *= self._imu_yaw_sign
        now = self.get_clock().now()

        if self._last_imu_raw_yaw is None:
            self._imu_unwrapped_yaw = yaw
        else:
            dt = (now - self._last_imu_time).nanoseconds / 1e9
            quaternion_delta = math.atan2(
                math.sin(yaw - self._last_imu_raw_yaw),
                math.cos(yaw - self._last_imu_raw_yaw))
            gyro_z = msg.angular_velocity.z * self._imu_yaw_sign
            quaternion_stalled = (
                abs(quaternion_delta) <= self._imu_quaternion_stall_delta)
            gyro_turning = abs(gyro_z) >= self._imu_gyro_deadband
            use_gyro = (
                self._imu_force_gyro_yaw or
                (self._imu_gyro_fallback and quaternion_stalled and gyro_turning))
            if use_gyro:
                delta = gyro_z * dt if gyro_turning else 0.0
            else:
                delta = quaternion_delta

            if (use_gyro and not self._using_gyro_fallback and
                    not self._imu_force_gyro_yaw):
                self.get_logger().warning(
                    '飞控四元数停滞，航向临时改用 gyro_z 积分')
            elif (not use_gyro and self._using_gyro_fallback and
                  not quaternion_stalled):
                self.get_logger().info('飞控四元数恢复，航向切回四元数')
            if (not self._imu_force_gyro_yaw and
                    (use_gyro or not quaternion_stalled)):
                self._using_gyro_fallback = use_gyro

            if 0.0 < dt <= self._imu_timeout_sec and abs(delta) <= self._imu_max_delta_rad:
                self._imu_unwrapped_yaw += delta
            else:
                self._imu_unwrapped_yaw = yaw
                self._imu_odom_offset = None
                self._using_gyro_fallback = False

        self._last_imu_raw_yaw = yaw
        self._last_imu_time = now

    def _decode_odom(self, header):
        """解码 0xCC/0xCD 包 → 发布 /wheel_counts、/odom 和 TF"""
        payload_end = 13 if header == HEADER_ODOM else 28
        checksum_index = 13 if header == HEADER_ODOM else 28
        cksum = 0
        for i in range(1, payload_end):
            cksum = (cksum + self._rx_buf[i]) & 0xFF
        if cksum != self._rx_buf[checksum_index]:
            return  # 校验失败，丢弃

        linear_velocity = 0.0
        angular_velocity = 0.0
        if header == HEADER_ODOM:
            x, y, theta = struct.unpack_from('<fff', self._rx_buf, 1)
        else:
            version, sequence, mcu_tick, x, y, theta, left_count, right_count = (
                struct.unpack_from('<BHIfffii', self._rx_buf, 1))
            if version != 1:
                self.get_logger().warning(f'不支持的底盘遥测版本: {version}')
                return

            counts_msg = Int64MultiArray()
            # [sequence, MCU 100us tick, left cumulative count, right cumulative count]
            counts_msg.data = [sequence, mcu_tick, left_count, right_count]
            self._wheel_counts_pub.publish(counts_msg)

            if self._last_sequence is not None:
                sequence_delta = (sequence - self._last_sequence) & 0xFFFF
                if sequence_delta != 1:
                    self.get_logger().warning(
                        f'底盘遥测序号跳变: {self._last_sequence} -> {sequence}')

            if self._last_wheel_sample is None:
                # 节点中途启动时先继承 MCU 当前位姿，下一帧起按累计计数差积分。
                self._odom_x = x / 1000.0
                self._odom_y = y / 1000.0
                self._odom_theta = theta
            else:
                old_tick, old_left, old_right = self._last_wheel_sample
                tick_delta = (mcu_tick - old_tick) & 0xFFFFFFFF
                dt = tick_delta * 0.0001
                if 0.001 <= dt <= 0.2:
                    dl = (left_count - old_left) * self._left_mpc
                    dr = (right_count - old_right) * self._right_mpc
                    ds = 0.5 * (dl + dr)
                    wheel_dtheta = (dr - dl) / self._wheel_separation
                    dtheta = wheel_dtheta
                    imu_fresh = (
                        self._use_imu_yaw and
                        self._imu_unwrapped_yaw is not None and
                        self._last_imu_time is not None and
                        (self.get_clock().now() - self._last_imu_time).nanoseconds / 1e9
                        <= self._imu_timeout_sec)
                    if imu_fresh:
                        if self._imu_odom_offset is None:
                            self._imu_odom_offset = (
                                self._odom_theta - self._imu_unwrapped_yaw)
                        imu_theta = math.atan2(
                            math.sin(self._imu_unwrapped_yaw + self._imu_odom_offset),
                            math.cos(self._imu_unwrapped_yaw + self._imu_odom_offset))
                        dtheta = math.atan2(
                            math.sin(imu_theta - self._odom_theta),
                            math.cos(imu_theta - self._odom_theta))
                    else:
                        self._imu_odom_offset = None
                    linear_velocity = ds / dt
                    angular_velocity = dtheta / dt
                    if self._integrate_from_counts:
                        theta_mid = self._odom_theta + 0.5 * dtheta
                        self._odom_x += ds * math.cos(theta_mid)
                        self._odom_y += ds * math.sin(theta_mid)
                        self._odom_theta = math.atan2(
                            math.sin(self._odom_theta + dtheta),
                            math.cos(self._odom_theta + dtheta))

            self._last_sequence = sequence
            self._last_wheel_sample = (mcu_tick, left_count, right_count)

        if header == HEADER_ODOM or not self._integrate_from_counts:
            self._odom_x = x / 1000.0
            self._odom_y = y / 1000.0
            self._odom_theta = theta

        now = self.get_clock().now()

        # 发布 /odom
        odom = Odometry()
        odom.header.stamp = now.to_msg()
        odom.header.frame_id = self._odom_frame
        odom.child_frame_id = self._base_frame

        odom.pose.pose.position.x = self._odom_x
        odom.pose.pose.position.y = self._odom_y
        odom.pose.pose.position.z = 0.0

        # 欧拉角 → 四元数
        half = self._odom_theta / 2.0
        odom.pose.pose.orientation.w = math.cos(half)
        odom.pose.pose.orientation.z = math.sin(half)
        odom.twist.twist.linear.x = linear_velocity
        odom.twist.twist.angular.z = angular_velocity

        # 协方差（编码器里程计，平移约 ±5cm/m，旋转约 ±2°/90°）
        odom.pose.covariance[0] = 0.01   # x
        odom.pose.covariance[7] = 0.01   # y
        odom.pose.covariance[35] = 0.01  # yaw
        odom.twist.covariance[0] = 0.1
        odom.twist.covariance[7] = 0.1
        odom.twist.covariance[35] = 0.1

        self._odom_pub.publish(odom)

        # 广播 TF
        if self._publish_tf:
            tf = TransformStamped()
            tf.header.stamp = now.to_msg()
            tf.header.frame_id = self._odom_frame
            tf.child_frame_id = self._base_frame
            tf.transform.translation.x = self._odom_x
            tf.transform.translation.y = self._odom_y
            tf.transform.translation.z = 0.0
            tf.transform.rotation = odom.pose.pose.orientation
            self._tf_broadcaster.sendTransform(tf)

    # ─── 发送：PC → MCU (0xBB 速度指令) ────────────────────────────

    def _cmd_vel_cb(self, msg: Twist):
        """保存最新 /cmd_vel，由定时器持续发给 MCU。"""
        self._target_linear = msg.linear.x
        self._target_angular = msg.angular.z
        self._last_cmd_time = self.get_clock().now()

    def _send_current_command(self):
        """按固定频率发送速度，/cmd_vel 超时后自动发送停车指令。"""
        linear = self._target_linear
        angular = self._target_angular

        if self._last_cmd_time is None:
            linear = 0.0
            angular = 0.0
        else:
            command_age = (
                self.get_clock().now() - self._last_cmd_time
            ).nanoseconds / 1e9
            if command_age > self._command_timeout_sec:
                linear = 0.0
                angular = 0.0

        self._send_velocity(linear, angular)

    def _send_velocity(self, linear: float, angular: float):
        """将速度转换为 0xBB 帧发给 MCU。"""
        # geometry_msgs/Twist: m/s, rad/s
        # MCU 期望: mm/s, mrad/s
        v_linear = int(linear * 1000.0)    # m/s → mm/s
        v_angular = int(angular * 1000.0)  # rad/s → mrad/s

        # 限幅（防止超出 MCU 预期范围）
        v_linear = max(-32767, min(32767, v_linear))
        v_angular = max(-32767, min(32767, v_angular))

        # 组帧: BB + v_linear(int16 BE) + v_angular(int16 BE) + cksum + 55
        buf = bytearray(7)
        buf[0] = HEADER_CMD

        # 大端 int16
        buf[1] = (v_linear >> 8) & 0xFF
        buf[2] = v_linear & 0xFF
        buf[3] = (v_angular >> 8) & 0xFF
        buf[4] = v_angular & 0xFF

        # 校验: bytes 1-4 累加
        cksum = (buf[1] + buf[2] + buf[3] + buf[4]) & 0xFF
        buf[5] = cksum
        buf[6] = FOOTER

        try:
            self._serial.write(buf)
        except Exception as e:
            self.get_logger().error(f'串口发送失败: {e}')


def main(args=None):
    rclpy.init(args=args)
    node = ChassisBridge()

    try:
        rclpy.spin(node)
    except KeyboardInterrupt:
        pass
    finally:
        node._send_velocity(0.0, 0.0)
        node.destroy_node()
        rclpy.shutdown()


if __name__ == '__main__':
    main()
