JiaXinTang-xiang/nav_n10/Telemetry framework/Device/IMU/ICM45686/IMU_45686.c

/* main.c file
编写者：lisn3188
网址：www.chiplab7.com
作者E-mail：lisn3188@163.com
编译环境：MDK-Lite  Version: 4.23
初版时间: 2012-04-25
测试： 本程序已在第七实验室的mini IMU上完成测试
功能：
姿态解算 IMU
将传感器的输出值进行姿态解算。得到目标载体的俯仰角和横滚角 和航向角
------------------------------------
 */
#include "tim.h"
#include "IMU_45686.h"
#include "usart.h" 
#include "inv_imu_driver.h"
#include "tool_delay.h"
/* XYZ结构体 */

/* 加速度：由南向北方向的加速度在加速度计的分量 *//* 加速度：由东向西方向的加速度在加速度计的分量 */
xyz_f_t north,west;
volatile float exInt, eyInt, ezInt;  // 误差积分
volatile float q0, q1, q2, q3; // 全局四元数
volatile float integralFBhand,handdiff;
volatile uint32_t lastUpdate, now; // 采样周期计数 单位 us
volatile float yaw[5]= {0,0,0,0,0};  //处理航向的增值
int16_t Ax_offset=0,Ay_offset=0;
float TTangles_gyro[7]; //彤彤滤波角度
	
float Angle_Final[3];	//X最终倾斜角度
float halfT;
float Kp = 10.0f;
static volatile float s_yaw_rate_radps;
static volatile float s_yaw_deg;

extern volatile uint32_t nowtime;

void MadgwickAHRSupdate(float gx, float gy, float gz, float ax, float ay, float az, float mx, float my, float mz);

extern int bsp_IcmGetRawData(float accel_mg[3], float gyro_dps[3], float *temp_degc);
// Fast inverse square-root
/**************************实现函数********************************************
*函数原型:	   float invSqrt(float x)
*功　　能:	   快速计算 1/Sqrt(x)
输入参数： 要计算的值
输出参数： 结果
*******************************************************************************/
float invSqrt1(float x) {
	float halfx = 0.5f * x;
	float y = x;
	long i = *(long*)&y;
	i = 0x5f3759df - (i>>1);
	y = *(float*)&i;
	y = y * (1.5f - (halfx * y * y));
	return y;
}

extern int setup_imu(int use_ln, int accel_en, int gyro_en);
/**************************实现函数********************************************
*函数原型:	   void IMU_init(void)
*功　　能:	  初始化IMU相关
			  初始化各个传感器
			  初始化四元数
			  将积分清零
			  更新系统时间
输入参数：无
输出参数：没有
*******************************************************************************/
void IMU_init(void)
{	 
	//while(!ICM_Init());	   //初始化ICM42688配置
	if (0x00 == setup_imu(1,1,1))
	{
		//TIM3_Init(100-1,84-1); // 100us 定时器
		HAL_TIM_Base_Start_IT(&htim6);
		// initialize quaternion
		q0 = 1.0f;  //初始化四元数
		q1 = 0.0f;
		q2 = 0.0f;
		q3 = 0.0f;
		exInt = 0.0;
		eyInt = 0.0;
		ezInt = 0.0;
		lastUpdate = nowtime;//更新时间
		now = nowtime;
		return;
	}
	
}

static double Gyro_fill[3][300];
static double Gyro_total[3];
static double sqrGyro_total[3];
static int GyroinitFlag = 0;
static int GyroCount = 0;

// 方差变形公式 S^2 = (X1^2 + X2^2 + X3^2 + ... +Xn^2)/n - X平均^2
// 函数名称: calVariance
// 功能描述: 计算方差
// 输入参数: data[] --- 参与计算方差的数据缓冲区
//           length --- 数据长度
// 输出参数:                                                                                      */
//           sqrResult[] --- 方差结果
//           avgResult[] --- 平均数

void calGyroVariance(float data[], int length, float sqrResult[], float avgResult[])
{
	int i;
	double tmplen;
	if (GyroinitFlag == 0)
	{
		for (i = 0; i< 3; i++)
		{
			Gyro_fill[i][GyroCount] = data[i];
			Gyro_total[i] += data[i];
			sqrGyro_total[i] += data[i] * data[i];
			sqrResult[i] = 100;
			avgResult[i] = 0;
		}
	}
	else
	{
		for (i = 0; i< 3; i++)
		{
			Gyro_total[i] -= Gyro_fill[i][GyroCount];
			sqrGyro_total[i] -= Gyro_fill[i][GyroCount] * Gyro_fill[i][GyroCount];
			Gyro_fill[i][GyroCount] = data[i];
			Gyro_total[i] += Gyro_fill[i][GyroCount];
			sqrGyro_total[i] += Gyro_fill[i][GyroCount] * Gyro_fill[i][GyroCount];
		}
	}
	GyroCount++;
	if (GyroCount >= length)
	{
		GyroCount = 0;
		GyroinitFlag = 1;
		Kp = 5.0f;
	}
	if (GyroinitFlag == 0)
	{
		return;
	}
	tmplen = length;
	for (i = 0; i< 3; i++)
	{
		avgResult[i] = (float)(Gyro_total[i] / tmplen);
		sqrResult[i] = (float)((sqrGyro_total[i] - Gyro_total[i] * Gyro_total[i] / tmplen) / tmplen);
	}
}
float gyro_offset[3] = {0};
int CalCount = 0;

/**************************实现函数********************************************
*函数原型:	   void IMU_getValues(float * values)
*功　　能:	 读取加速度 陀螺仪 磁力计 的当前值
输入参数： 将结果存放的数组首地址
输出参数：没有
*******************************************************************************/
void IMU_getValues(float * values) {  
	float accgyroval[7];
//	icm42688RealData_t accval;
//	icm42688RealData_t gyroval;
	
	float sqrResult_gyro[3];
	float avgResult_gyro[3];
	//读取加速度和陀螺仪的当前ADC
	bsp_IcmGetRawData(accgyroval, &accgyroval[3], &accgyroval[6]);
    TTangles_gyro[0] =  accgyroval[0];
    TTangles_gyro[1] =  accgyroval[1];
    TTangles_gyro[2] =  accgyroval[2];
	TTangles_gyro[3] =  accgyroval[3];
	TTangles_gyro[4] =  accgyroval[4];
	TTangles_gyro[5] =  accgyroval[5];
	TTangles_gyro[6] =  accgyroval[6];
	
	calGyroVariance(&TTangles_gyro[3], 100, sqrResult_gyro, avgResult_gyro);
	if (sqrResult_gyro[0] < 0.02f && sqrResult_gyro[1] < 0.02f && sqrResult_gyro[2] < 0.02f && CalCount >= 99)
	{
		gyro_offset[0] = avgResult_gyro[0];
		gyro_offset[1] = avgResult_gyro[1];
		gyro_offset[2] = avgResult_gyro[2];
		exInt = 0;
		eyInt = 0;
		ezInt = 0;
		CalCount = 0;
	}
	else if (CalCount < 100)
	{
		CalCount++;
	}
    values[0] =  accgyroval[0];
    values[1] =  accgyroval[1];
    values[2] =  accgyroval[2];
	values[3] =  accgyroval[3] - gyro_offset[0];
	values[4] =  accgyroval[4] - gyro_offset[1];
	values[5] =  accgyroval[5] - gyro_offset[2];
	s_yaw_rate_radps = values[5] * M_PI / 180.0f;
	

		//这里已经将量程改成了 1000度每秒  32.8 对应 1度每秒
}


/**************************实现函数********************************************
*函数原型:	   void IMU_AHRSupdate
*功　　能:	 更新AHRS 更新四元数
输入参数： 当前的测量值。
输出参数：没有
*******************************************************************************/
#define Ki 0.005f   // integral gain governs rate of convergence of gyroscope biases

void IMU_AHRSupdate(float gx, float gy, float gz, float ax, float ay, float az, float mx, float my, float mz) {
  float norm;
  //float hx, hy, hz, bx, bz;
  float vx, vy, vz;//, wx, wy, wz;
  float ex, ey, ez;
  float tempq0,tempq1,tempq2,tempq3;

  // 先把这些用得到的值算好
  float q0q0 = q0*q0;
  float q0q1 = q0*q1;
  float q0q2 = q0*q2;
  float q0q3 = q0*q3;
  float q1q1 = q1*q1;
  float q1q2 = q1*q2;
  float q1q3 = q1*q3;
  float q2q2 = q2*q2;   
  float q2q3 = q2*q3;
  float q3q3 = q3*q3;   
////====================================================================================================================================
//	//20160323v0.4.6
//	//此处增加了一些机动检测使用的变量
//	//设置延迟启动机动检测的判据
//	static int s_InitTickCount=0;
//	float an[3]={0,0,0};
//	float Cb2n[3*3]={0};
//	

////====================================================================================================================================
//	
  
  now = nowtime;  //读取时间
  if(now<lastUpdate){ //定时器溢出过了。
	halfT =  ((float)(now + (0xffff- lastUpdate)) / 20000.0f);
  }
  else	{
	halfT =  ((float)(now - lastUpdate) / 20000.0f);
  }
  lastUpdate = now;	//更新时间
  
  norm = invSqrt1(ax*ax + ay*ay + az*az);       
  ax = ax * norm;
  ay = ay * norm;
  az = az * norm;
  //把加计的三维向量转成单位向量。

  norm = invSqrt1(mx*mx + my*my + mz*mz);
  mx = mx * norm;
  my = my * norm;
  mz = mz * norm;

  /*
  这是把四元数换算成《方向余弦矩阵》中的第三列的三个元素。
根据余弦矩阵和欧拉角的定义，地理坐标系的重力向量，转到机体坐标系，正好是这三个元素。
所以这里的vx\y\z，其实就是当前的欧拉角（即四元数）的机体坐标参照系上，换算出来的重力单位向量。
  */
  // compute reference direction of flux
//  hx = 2*mx*(0.5f - q2q2 - q3q3) + 2*my*(q1q2 - q0q3) + 2*mz*(q1q3 + q0q2);
//  hy = 2*mx*(q1q2 + q0q3) + 2*my*(0.5f - q1q1 - q3q3) + 2*mz*(q2q3 - q0q1);
//  hz = 2*mx*(q1q3 - q0q2) + 2*my*(q2q3 + q0q1) + 2*mz*(0.5f - q1q1 - q2q2);         
//  bx = sqrt((hx*hx) + (hy*hy));
//  bz = hz;     
  
  // estimated direction of gravity and flux (v and w)
  vx = 2*(q1q3 - q0q2);
  vy = 2*(q0q1 + q2q3);
  vz = q0q0 - q1q1 - q2q2 + q3q3;
  
  /* 加速度：由南向北方向的加速度在加速度计X分量 */
	north.x = 1 - 2*(q3*q3 + q2*q2);
	/* 加速度：由南向北方向的加速度在加速度计Y分量 */
	north.y = 2* (-q0*q3 + q1*q2);
	/* 加速度：由南向北方向的加速度在加速度计Z分量 */
	north.z = 2* (+q0*q2  - q1*q3);
	/* 加速度：由东向西方向的加速度在加速度计X分量 */
	west.x = 2* (+q0*q3 + q1*q2);
	/* 加速度：由东向西方向的加速度在加速度计Y分量 */
	west.y = 1 - 2*(q3*q3 + q1*q1);
	/* 加速度：由东向西方向的加速度在加速度计Z分量 */
	west.z = 2* (-q0*q1 + q2*q3);
//  wx = 2*bx*(0.5 - q2q2 - q3q3) + 2*bz*(q1q3 - q0q2);
//  wy = 2*bx*(q1q2 - q0q3) + 2*bz*(q0q1 + q2q3);
//  wz = 2*bx*(q0q2 + q1q3) + 2*bz*(0.5 - q1q1 - q2q2);  
  
  // error is sum of cross product between reference direction of fields and direction measured by sensors
  ex = (ay*vz - az*vy);// + (my*wz - mz*wy);
  ey = (az*vx - ax*vz);// + (mz*wx - mx*wz);
  ez = (ax*vy - ay*vx);// + (mx*wy - my*wx);
  /*
  axyz是机体坐标参照系上，加速度计测出来的重力向量，也就是实际测出来的重力向量。
axyz是测量得到的重力向量，vxyz是陀螺积分后的姿态来推算出的重力向量，它们都是机体坐标参照系上的重力向量。
那它们之间的误差向量，就是陀螺积分后的姿态和加计测出来的姿态之间的误差。
向量间的误差，可以用向量叉积（也叫向量外积、叉乘）来表示，exyz就是两个重力向量的叉积。
这个叉积向量仍旧是位于机体坐标系上的，而陀螺积分误差也是在机体坐标系，而且叉积的大小与陀螺积分误差成正比，正好拿来纠正陀螺。（你可以自己拿东西想象一下）由于陀螺是对机体直接积分，所以对陀螺的纠正量会直接体现在对机体坐标系的纠正。
  */
if(ex != 0.0f && ey != 0.0f && ez != 0.0f){
  exInt = exInt + ex * Ki * halfT;
  eyInt = eyInt + ey * Ki * halfT;	
  ezInt = ezInt + ez * Ki * halfT;

  // 用叉积误差来做PI修正陀螺零偏
  gx = gx + Kp*ex + exInt;
  gy = gy + Kp*ey + eyInt;
  gz = gz + Kp*ez + ezInt;

  }

  // 四元数微分方程
  tempq0 = q0 + (-q1*gx - q2*gy - q3*gz)*halfT;
  tempq1 = q1 + (q0*gx + q2*gz - q3*gy)*halfT;
  tempq2 = q2 + (q0*gy - q1*gz + q3*gx)*halfT;
  tempq3 = q3 + (q0*gz + q1*gy - q2*gx)*halfT;  
  
  // 四元数规范化
  norm = invSqrt1(tempq0*tempq0 + tempq1*tempq1 + tempq2*tempq2 + tempq3*tempq3);
  q0 = tempq0 * norm;
  q1 = tempq1 * norm;
  q2 = tempq2 * norm;
  q3 = tempq3 * norm;
}


/**************************实现函数********************************************
*函数原型:	   void IMU_getQ(float * q)
*功　　能:	 更新四元数 返回当前的四元数组值
输入参数： 将要存放四元数的数组首地址
输出参数：没有
*******************************************************************************/
float mygetqval[9];	//用于存放传感器转换结果的数组
void IMU_getQ(float * q) {

  IMU_getValues(mygetqval);
  //将陀螺仪的测量值转成弧度每秒
  //加速度从mg转换为g单位（bsp_IcmGetRawData返回的是mg）
  IMU_AHRSupdate(mygetqval[3] * M_PI/180, mygetqval[4] * M_PI/180, mygetqval[5] * M_PI/180,
   mygetqval[0] / 1000.0f, mygetqval[1] / 1000.0f, mygetqval[2] / 1000.0f, mygetqval[6], mygetqval[7], mygetqval[8]);

  q[0] = q0; //返回当前值
  q[1] = q1;
  q[2] = q2;
  q[3] = q3;
}


/**************************实现函数********************************************
*函数原型:	   void IMU_getYawPitchRoll(float * angles)
*功　　能:	 更新四元数 返回当前解算后的姿态数据
输入参数： 将要存放姿态角的数组首地址
输出参数：没有
*******************************************************************************/
void IMU_getYawPitchRoll(float * angles) {
  float q[4]; //　四元数
  volatile float gx=0.0, gy=0.0, gz=0.0; //估计重力方向
  IMU_getQ(q); //更新全局四元数
  
  angles[0] = -atan2(2 * q[1] * q[2] + 2 * q[0] * q[3], -2 * q[2]*q[2] - 2 * q[3] * q[3] + 1)* 180/M_PI; // yaw
  angles[1] = -asin(-2 * q[1] * q[3] + 2 * q[0] * q[2])* 180/M_PI; // pitch
  angles[2] = atan2(2 * q[2] * q[3] + 2 * q[0] * q[1], -2 * q[1] * q[1] - 2 * q[2] * q[2] + 1)* 180/M_PI; // roll
  s_yaw_deg = angles[0]; /* 单次发布，200Hz 底盘任务只读，不访问 SPI。 */
 // if(angles[0]<0)angles[0]+=360.0f;  //将 -+180度  转成0-360度
}

float IMU_GetYawRateRadps(void)
{
  return s_yaw_rate_radps;
}

float IMU_GetYawDeg(void)
{
  return s_yaw_deg;
}

 void IMU_TT_getgyro(float * zsjganda)
{
	zsjganda[0] = TTangles_gyro[0];
    zsjganda[1] = TTangles_gyro[1];
    zsjganda[2] = TTangles_gyro[2];
	zsjganda[3] = TTangles_gyro[3];
	zsjganda[4] = TTangles_gyro[4];
	zsjganda[5] = TTangles_gyro[5];
	zsjganda[6] = TTangles_gyro[6];
}

void MPU6050_InitAng_Offset(void)
{

}
//------------------End of File----------------------------
