JiaXinTang-xiang/nav_n10/Telemetry framework/Device/Hardware/oled.c

/**
****************************(C) COPYRIGHT 2019 DJI****************************
 * @file       oled.c/h
 * @brief      0.96 inch oled use SSD1306 driver. the file includes oled initialization function,
 *             and some OLED setting function, GRAM operate function, oled show num ,char and string function,
 *             show RoboMaster LOGO function.
 *             0.96寸OLED使用SSD1306驱动, 本文件包括OLED初始化函数, 以及OLED设置函数, GRAM操作函数,
 *             oled显示数字、字符、字符串函数, 以及显示RoboMaster LOGO函数
 * @note
 * @history
 *  Version    Date            Author          Modification
 *  V1.0.0     Dec-26-2018     RM              1. done
 *
@verbatim
================================================================================
================================================================================
@endverbatim
****************************(C) COPYRIGHT 2019 DJI****************************
 */

#include "oled.h"
#include "oledfont.h"
#include <stdarg.h>
#include <stdio.h>



extern I2C_HandleTypeDef hi2c2;

static uint8_t OLED_GRAM[128][8];



/**
  * @brief          write data/command to OLED, if you use spi, please rewrite the function
  * @param[in]      dat: the data ready to write
  * @param[in]      cmd: OLED_CMD means command; OLED_DATA means data
  * @retval         none
  */
/**
  * @brief          写数据或指令到OLED, 如果使用SPI请重写此函数
  * @param[in]      dat: 要写入的数据字节
  * @param[in]      cmd: OLED_CMD 表示写入指令字节; OLED_DATA 表示写入数据字节
  * @retval         none
  */
void oled_write_byte(uint8_t dat, uint8_t cmd)
{
    static uint8_t cmd_data[2];
    if(cmd == OLED_CMD)
    {
        cmd_data[0] = 0x00;
    }
    else
    {
        cmd_data[0] = 0x40;
    }
    cmd_data[1] = dat;
    HAL_I2C_Master_Transmit(&hi2c2, OLED_I2C_ADDRESS, cmd_data, 2, 10);
}


/**
  * @brief          initialize the oled device
  * @param[in]      none
  * @retval         none
  */
/**
  * @brief          初始化OLED模块
  * @param[in]      none
  * @retval         none
  */
void OLED_init(void)
{
    oled_write_byte(0xAE, OLED_CMD);    //display off
    oled_write_byte(0x20, OLED_CMD);    //Set Memory Addressing Mode
    oled_write_byte(0x10, OLED_CMD);    //00,Horizontal Addressing Mode;01,Vertical Addressing Mode;10,Page Addressing Mode (RESET);11,Invalid
    oled_write_byte(0xb0, OLED_CMD);    //Set Page Start Address for Page Addressing Mode,0-7
    oled_write_byte(0xc8, OLED_CMD);    //Set COM Output Scan Direction
    oled_write_byte(0x00, OLED_CMD);    //---set low column address
    oled_write_byte(0x10, OLED_CMD);    //---set high column address
    oled_write_byte(0x40, OLED_CMD);    //--set start line address
    oled_write_byte(0x81, OLED_CMD);    //--set contrast control register
    oled_write_byte(0xff, OLED_CMD);    //brightness 0x00~0xff
    oled_write_byte(0xa1, OLED_CMD);    //--set segment re-map 0 to 127
    oled_write_byte(0xa6, OLED_CMD);    //--set normal display
    oled_write_byte(0xa8, OLED_CMD);    //--set multiplex ratio(1 to 64)
    oled_write_byte(0x3F, OLED_CMD);    //
    oled_write_byte(0xa4, OLED_CMD);    //0xa4,Output follows RAM content;0xa5,Output ignores RAM content
    oled_write_byte(0xd3, OLED_CMD);    //-set display offset
    oled_write_byte(0x00, OLED_CMD);    //-not offset
    oled_write_byte(0xd5, OLED_CMD);    //--set display clock divide ratio/oscillator frequency
    oled_write_byte(0xf0, OLED_CMD);    //--set divide ratio
    oled_write_byte(0xd9, OLED_CMD);    //--set pre-charge period
    oled_write_byte(0x22, OLED_CMD);    //
    oled_write_byte(0xda, OLED_CMD);    //--set com pins hardware configuration
    oled_write_byte(0x12, OLED_CMD);
    oled_write_byte(0xdb, OLED_CMD);    //--set vcomh
    oled_write_byte(0x20, OLED_CMD);    //0x20,0.77xVcc
    oled_write_byte(0x8d, OLED_CMD);    //--set DC-DC enable
    oled_write_byte(0x14, OLED_CMD);    //
    oled_write_byte(0xaf, OLED_CMD);    //--turn on oled panel
}

/**
  * @brief          turn on OLED display
  * @param[in]      none
  * @retval         none
  */
/**
  * @brief          开启OLED显示
  * @param[in]      none
  * @retval         none
  */
void OLED_display_on(void)
{
    oled_write_byte(0x8d, OLED_CMD);
    oled_write_byte(0x14, OLED_CMD);
    oled_write_byte(0xaf, OLED_CMD);
}

/**
  * @brief          turn off OLED display
  * @param[in]      none
  * @retval         none
  */
/**
  * @brief          关闭OLED显示
  * @param[in]      none
  * @retval         none
  */
void OLED_display_off(void)
{
    oled_write_byte(0x8d, OLED_CMD);
    oled_write_byte(0x10, OLED_CMD);
    oled_write_byte(0xae, OLED_CMD);
}

/**
  * @brief          operate the graphic ram(size: 128*8 char)
  * @param[in]      pen: the type of operate.
                    PEN_CLEAR: set ram to 0x00
                    PEN_WRITE: set ram to 0xff
                    PEN_INVERSION: bit inversion
  * @retval         none
  */
/**
  * @brief          操作GRAM内存(128*8char大小的二维数组)
  * @param[in]      pen: 操作类型.
                    PEN_CLEAR: 清零为0x00
                    PEN_WRITE: 置一为0xff
                    PEN_INVERSION: 按位取反
  * @retval         none
  */
void OLED_operate_gram(pen_typedef pen)
{
    uint8_t i, n;

    for (i = 0; i < 8; i++)
    {
        for (n = 0; n < 128; n++)
        {
            if (pen == PEN_WRITE)
            {
                OLED_GRAM[n][i] = 0xff;
            }
            else if (pen == PEN_CLEAR)
            {
                OLED_GRAM[n][i] = 0x00;
            }
            else
            {
                OLED_GRAM[n][i] = 0xff - OLED_GRAM[n][i];
            }
        }
    }
}

/**
  * @brief          cursor set to (x,y) point
  * @param[in]      x:X-axis, from 0 to 127
  * @param[in]      y:Y-axis, from 0 to 7
  * @retval         none
  */
/**
  * @brief          设置光标位置(x,y)
  * @param[in]      x:x坐标, 范围 0 到 127
  * @param[in]      y:y坐标, 范围 0 到 7
  * @retval         none
  */
void OLED_set_pos(uint8_t x, uint8_t y)
{
    oled_write_byte((0xb0 + y), OLED_CMD);              //set page address y
    oled_write_byte(((x&0xf0)>>4)|0x10, OLED_CMD);      //set column high address
    oled_write_byte((x&0x0f), OLED_CMD);                //set column low address
}


/**
  * @brief          draw one bit of graphic raw, operate one point of screan(128*64)
  * @param[in]      x: x-axis, [0, X_WIDTH-1]
  * @param[in]      y: y-axis, [0, Y_WIDTH-1]
  * @param[in]      pen: type of operation,
                        PEN_CLEAR: set (x,y) to 0
                        PEN_WRITE: set (x,y) to 1
                        PEN_INVERSION: (x,y) value inversion
  * @retval         none
  */
/**
  * @brief          画GRAM中的一个位,相当于在屏幕上画一个点
  * @param[in]      x:x坐标,  [0,X_WIDTH-1]
  * @param[in]      y:y坐标,  [0,Y_WIDTH-1]
  * @param[in]      pen: 操作类型,
                        PEN_CLEAR: 清除 (x,y) 为 0
                        PEN_WRITE: 绘制 (x,y) 为 1
                        PEN_INVERSION: (x,y) 值取反
  * @retval         none
  */
void OLED_draw_point(int8_t x, int8_t y, pen_typedef pen)
{
    uint8_t page = 0, row = 0;

    /* check the corrdinate */
    if ((x < 0) || (x > (X_WIDTH - 1)) || (y < 0) || (y > (Y_WIDTH - 1)))
    {
        return;
    }
    page = y / 8;
    row = y % 8;

    if (pen == PEN_WRITE)
    {
        OLED_GRAM[x][page] |= 1 << row;
    }
    else if (pen == PEN_INVERSION)
    {
        OLED_GRAM[x][page] ^= 1 << row;
    }
    else
    {
        OLED_GRAM[x][page] &= ~(1 << row);
    }
}




/**
  * @brief          draw a line from (x1, y1) to (x2, y2)
  * @param[in]      x1: the start point of line
  * @param[in]      y1: the start point of line
  * @param[in]      x2: the end point of line
  * @param[in]      y2: the end point of line
  * @param[in]      pen: type of operation,PEN_CLEAR,PEN_WRITE,PEN_INVERSION.
  * @retval         none
  */
/**
  * @brief          画一条直线，从(x1,y1)到(x2,y2)
  * @param[in]      x1: 起点
  * @param[in]      y1: 起点
  * @param[in]      x2: 终点
  * @param[in]      y2: 终点
  * @param[in]      pen: 操作类型,PEN_CLEAR,PEN_WRITE,PEN_INVERSION.
  * @retval         none
  */

void OLED_draw_line(uint8_t x1, uint8_t y1, uint8_t x2, uint8_t y2, pen_typedef pen)
{
    uint8_t col = 0, row = 0;
    uint8_t x_st = 0, x_ed = 0, y_st = 0, y_ed = 0;
    float k = 0.0f, b = 0.0f;

    if (y1 == y2)
    {
        (x1 <= x2) ? (x_st = x1):(x_st = x2);
        (x1 <= x2) ? (x_ed = x2):(x_ed = x1);

        for (col = x_st; col <= x_ed; col++)
        {
            OLED_draw_point(col, y1, pen);
        }
    }
    else if (x1 == x2)
    {
        (y1 <= y2) ? (y_st = y1):(y_st = y2);
        (y1 <= y2) ? (y_ed = y2):(y_ed = y1);

        for (row = y_st; row <= y_ed; row++)
        {
            OLED_draw_point(x1, row, pen);
        }
    }
    else
    {
        k = ((float)(y2 - y1)) / (x2 - x1);
        b = (float)y1 - k * x1;

        (x1 <= x2) ? (x_st = x1):(x_st = x2);
        (x1 <= x2) ? (x_ed = x2):(x_ed = x2);

        for (col = x_st; col <= x_ed; col++)
        {
            OLED_draw_point(col, (uint8_t)(col * k + b), pen);
        }
    }
}


/**
  * @brief          show a character
  * @param[in]      row: start row of character
  * @param[in]      col: start column of character
  * @param[in]      chr: the character ready to show
  * @retval         none
  */
/**
  * @brief          显示一个字符
  * @param[in]      row: 字符的起始行
  * @param[in]      col: 字符的起始列
  * @param[in]      chr: 字符
  * @retval         none
  */
void OLED_show_char(uint8_t row, uint8_t col, uint8_t chr)
{
    uint8_t x = col * 6;
    uint8_t y = row * 12;
    uint8_t temp, t, t1;
    uint8_t y0 = y;
    chr = chr - ' ';

    for (t = 0; t < 12; t++)
    {
        temp = asc2_1206[chr][t];

        for (t1 = 0; t1 < 8; t1++)
        {
            if (temp&0x80)
                OLED_draw_point(x, y, PEN_WRITE);
            else
                OLED_draw_point(x, y, PEN_CLEAR);

            temp <<= 1;
            y++;
            if ((y - y0) == 12)
            {
                y = y0;
                x++;
                break;
            }
        }
    }
}


/**
  * @brief          show a character string
  * @param[in]      row: row of character string begin
  * @param[in]      col: column of character string begin
  * @param[in]      chr: the pointer to character string
  * @retval         none
  */
/**
  * @brief          显示一个字符串
  * @param[in]      row: 字符串的起始行
  * @param[in]      col: 字符串的起始列
  * @param[in]      chr: 字符串指针
  * @retval         none
  */
void OLED_show_string(uint8_t row, uint8_t col, uint8_t *chr)
{
    uint8_t n =0;

    while (chr[n] != '\0')
    {
        OLED_show_char(row, col, chr[n]);
        col++;

        if (col > 20)
        {
            col = 0;
            row += 1;
        }
        n++;
    }
}


/**
  * @brief          formatted output in oled 128*64
  * @param[in]      row: row of character string begin, 0 <= row <= 4;
  * @param[in]      col: column of character string begin, 0 <= col <= 20;
  * @param          *fmt: the pointer to format character string
  * @note           if the character length is more than one row at a time, the extra characters will be truncated
  * @retval         none
  */
/**
  * @brief          格式化打印
  * @param[in]      row: 起始行,0 <= row <= 4;
  * @param[in]      col: 起始列, 0 <= col <= 列最大值 20;
  * @param[in]      *fmt:格式化字符串指针
  * @note           如果字符串长度超过一行，多余的字符会被截断
  * @retval         none
  */
void OLED_printf(uint8_t row, uint8_t col, const char *fmt,...)
{
    static uint8_t LCD_BUF[128] = {0};
    static va_list ap;
    uint8_t remain_size = 0;

    if ((row > 4) || (col > 20) )
    {
        return;
    }
    va_start(ap, fmt);

    vsprintf((char *)LCD_BUF, fmt, ap);

    va_end(ap);

    remain_size = 21 - col;

    LCD_BUF[remain_size] = '\0';

    OLED_show_string(row, col, LCD_BUF);
}

/**
  * @brief          send the data of gram to oled sreen
  * @param[in]      none
  * @retval         none
  */
/**
  * @brief          将GRAM数据发送到OLED的GRAM
  * @param[in]      none
  * @retval         none
  */
void OLED_refresh_gram(void)
{
    uint8_t i, n;

    for (i = 0; i < 8; i++)
    {
        OLED_set_pos(0, i);
        for (n = 0; n < 128; n++)
        {
            oled_write_byte(OLED_GRAM[n][i], OLED_DATA);
        }
    }
}




/**
  * @brief          show the logo of RoboMaster
  * @param[in]      none
  * @retval         none
  */
/**
  * @brief          显示RM的LOGO
  * @param[in]      none
  * @retval         none
  */
void OLED_LOGO(void)
{
    uint8_t temp_char = 0;
    uint8_t x = 0, y = 0;
    uint8_t i = 0;
    OLED_operate_gram(PEN_CLEAR);


    for(; y < 64; y += 8)
    {
        for(x = 0; x < 128; x++)
        {
            temp_char = LOGO_BMP[x][y/8];
            for(i = 0; i < 8; i++)
            {
                if(temp_char & 0x80)
                {
                    OLED_draw_point(x, y + i,PEN_WRITE);
                }
                else
                {
                    OLED_draw_point(x,y + i,PEN_CLEAR);
                }
                temp_char <<= 1;
            }
        }
    }
    OLED_refresh_gram();
}
