JiaXinTang-xiang/nav_n10/firmware_fc/ANO_LX_FC_ROS/DriversMcu/STM32F407/Drivers/Drv_Uart.c

/******************** (C) COPYRIGHT 2017 ANO Tech ********************************
 * 作者    ：匿名科创
 * 官网    ：www.anotc.com
 * 淘宝    ：anotc.taobao.com
 * 技术Q群 ：190169595
 * 描述    ：串口驱动
**********************************************************************************/
#include "Drv_Uart.h"
#include "Ano_DT_LX.h"
#include "AnoDTRasp.h"
#include "Drv_UbloxGPS.h"
#include "Drv_AnoOf.h"


void NoUse(u8 data){}
//串口接收发送快速定义，直接修改此处的函数名称宏，修改成自己的串口解析和发送函数名称即可，注意函数参数格式需统一
#define U1GetOneByte	Send_Data_To_32 
#define U2GetOneByte	Recive_K230data//AnoDTRaspRecvOneByte
#define U3GetOneByte	AnoDTRaspRecvOneByte
#define U4GetOneByte	AnoOF_GetOneByteChoose
#define U5GetOneByte	AnoDTIMURecvOneByte
	
//====uart1
void DrvUart1Init(u32 br_num)
{
    USART_InitTypeDef USART_InitStructure;
    USART_ClockInitTypeDef USART_ClockInitStruct;
    NVIC_InitTypeDef NVIC_InitStructure;
    GPIO_InitTypeDef GPIO_InitStructure;

    USART_StructInit(&USART_InitStructure);

    RCC_APB2PeriphClockCmd(RCC_APB2Periph_USART1, ENABLE); //开启USART1时钟
    RCC_AHB1PeriphClockCmd(RCC_AHB1Periph_GPIOA, ENABLE);

    //串口中断优先级
    NVIC_InitStructure.NVIC_IRQChannel = USART1_IRQn;
    NVIC_InitStructure.NVIC_IRQChannelPreemptionPriority = NVIC_UART1_P;
    NVIC_InitStructure.NVIC_IRQChannelSubPriority = NVIC_UART1_S;
    NVIC_InitStructure.NVIC_IRQChannelCmd = ENABLE;
    NVIC_Init(&NVIC_InitStructure);

    GPIO_PinAFConfig(GPIOA, GPIO_PinSource9, GPIO_AF_USART1);
    GPIO_PinAFConfig(GPIOA, GPIO_PinSource10, GPIO_AF_USART1);

    //配置PA9作为USART1　Tx
    GPIO_InitStructure.GPIO_Pin = GPIO_Pin_9;
    GPIO_InitStructure.GPIO_Mode = GPIO_Mode_AF;
    GPIO_InitStructure.GPIO_Speed = GPIO_Speed_50MHz;
    GPIO_InitStructure.GPIO_OType = GPIO_OType_PP;
    GPIO_InitStructure.GPIO_PuPd = GPIO_PuPd_UP;
    GPIO_Init(GPIOA, &GPIO_InitStructure);
    //配置PA10作为USART1　Rx
    GPIO_InitStructure.GPIO_Pin = GPIO_Pin_10;
    GPIO_InitStructure.GPIO_Mode = GPIO_Mode_AF;
    GPIO_InitStructure.GPIO_Speed = GPIO_Speed_50MHz;
    GPIO_InitStructure.GPIO_OType = GPIO_OType_OD;
    GPIO_InitStructure.GPIO_PuPd = GPIO_PuPd_NOPULL;
    GPIO_Init(GPIOA, &GPIO_InitStructure);
    //
    USART_DeInit(USART1);
    //配置USART1
    //中断被屏蔽了
    USART_InitStructure.USART_BaudRate = br_num;                                    //波特率可以通过地面站配置
    USART_InitStructure.USART_WordLength = USART_WordLength_8b;                     //8位数据
    USART_InitStructure.USART_StopBits = USART_StopBits_1;                          //在帧结尾传输1个停止位
    USART_InitStructure.USART_Parity = USART_Parity_No;                             //禁用奇偶校验
    USART_InitStructure.USART_HardwareFlowControl = USART_HardwareFlowControl_None; //硬件流控制失能
    USART_InitStructure.USART_Mode = USART_Mode_Tx | USART_Mode_Rx;                 //发送、接收使能
    //配置USART1时钟
    USART_ClockInitStruct.USART_Clock = USART_Clock_Disable;     //时钟低电平活动
    USART_ClockInitStruct.USART_CPOL = USART_CPOL_Low;           //SLCK引脚上时钟输出的极性->低电平
    USART_ClockInitStruct.USART_CPHA = USART_CPHA_2Edge;         //时钟第二个边沿进行数据捕获
    USART_ClockInitStruct.USART_LastBit = USART_LastBit_Disable; //最后一位数据的时钟脉冲不从SCLK输出

    USART_Init(USART1, &USART_InitStructure);
    USART_ClockInit(USART1, &USART_ClockInitStruct);

    //使能USART1接收中断
    USART_ITConfig(USART1, USART_IT_RXNE, ENABLE);
    //使能USART1
    USART_Cmd(USART1, ENABLE);
}

u8 Tx1Buffer[256];
u8 Tx1Counter = 0;
u8 count1 = 0;
void DrvUart1SendBuf(unsigned char *DataToSend, u8 data_num)
{
    u8 i;
    for (i = 0; i < data_num; i++)
    {
        Tx1Buffer[count1++] = *(DataToSend + i);
    }

    if (!(USART1->CR1 & USART_CR1_TXEIE))
    {
        USART_ITConfig(USART1, USART_IT_TXE, ENABLE); //打开发送中断
    }
}
// 发送 int16 数组
void DrvUart1SendInt16Buf(int16_t *values, u8 num)
{
    for (u8 i = 0; i < num; i++)
    {
        // 将每个 int16 拆分为两个字节
        u8 low_byte = values[i] & 0xFF;        // 低字节
        u8 high_byte = (values[i] >> 8) & 0xFF; // 高字节
        
        // 添加到发送缓冲区
        Tx1Buffer[count1++] = low_byte;
        if(count1 >= sizeof(Tx1Buffer)) count1 = 0; // 循环缓冲区
        
        Tx1Buffer[count1++] = high_byte;
        if(count1 >= sizeof(Tx1Buffer)) count1 = 0; // 循环缓冲区
    }
    
    // 如果发送中断未启用，则启用
    if (!(USART1->CR1 & USART_CR1_TXEIE))
    {
        USART_ITConfig(USART1, USART_IT_TXE, ENABLE);
    }
}

void DrvUart1SendDouble(double value)
{
    // 将 double 转换为字节数组
    u8 *bytes = (u8 *)&value;
    
    // 将每个字节添加到发送缓冲区
    for (u8 i = 0; i < sizeof(double); i++)
    {
        Tx1Buffer[count1++] = bytes[i];
        
        // 检查缓冲区是否已满
        if (count1 >= sizeof(Tx1Buffer))
        {
            count1 = 0; // 循环缓冲区，防止溢出
        }
    }
    
    // 如果发送中断未启用，则启用
    if (!(USART1->CR1 & USART_CR1_TXEIE))
    {
        USART_ITConfig(USART1, USART_IT_TXE, ENABLE);
    }
}
// 发送 double 数组
void DrvUart1SendDoubles(double *values, u8 num)
{
    for (u8 i = 0; i < num; i++)
    {
        // 将每个 double 转换为字节数组
        u8 *bytes = (u8 *)&values[i];
        
        for (u8 j = 0; j < sizeof(double); j++)
        {
            Tx1Buffer[count1++] = bytes[j];
            
            // 检查缓冲区是否已满
            if (count1 >= sizeof(Tx1Buffer))
            {
                count1 = 0; // 循环缓冲区，防止溢出
            }
        }
    }
    
    // 如果发送中断未启用，则启用
    if (!(USART1->CR1 & USART_CR1_TXEIE))
    {
        USART_ITConfig(USART1, USART_IT_TXE, ENABLE);
    }
}

u8 U1RxDataTmp[100];
u8 U1RxInCnt = 0;
u8 U1RxoutCnt = 0;
void drvU1GetByte(u8 data)
{
	U1RxDataTmp[U1RxInCnt++] = data;
	if(U1RxInCnt >= 100)
		U1RxInCnt = 0;
}
void drvU1DataCheck(void)
{
	while(U1RxInCnt!=U1RxoutCnt)
	{
		U1GetOneByte(U1RxDataTmp[U1RxoutCnt++]);
		if(U1RxoutCnt >= 100)
			U1RxoutCnt = 0;
	}
}
void Usart1_IRQ(void)
{
    u8 com_data;

    if (USART1->SR & USART_SR_ORE) //ORE中断
    {
        com_data = USART1->DR;
    }
    //接收中断
    if (USART_GetITStatus(USART1, USART_IT_RXNE))
    {
        USART_ClearITPendingBit(USART1, USART_IT_RXNE); //清除中断标志
        com_data = USART1->DR;
        drvU1GetByte(com_data);
    }
    //发送（进入移位）中断
    if (USART_GetITStatus(USART1, USART_IT_TXE))
    {
        USART1->DR = Tx1Buffer[Tx1Counter++]; //写DR清除中断标志
        if (Tx1Counter == count1)
        {
            USART1->CR1 &= ~USART_CR1_TXEIE; //关闭TXE（发送中断）中断
        }
    }
}



//====uart2
void DrvUart2Init(u32 br_num)
{
    USART_InitTypeDef USART_InitStructure;
    USART_ClockInitTypeDef USART_ClockInitStruct;
    NVIC_InitTypeDef NVIC_InitStructure;
    GPIO_InitTypeDef GPIO_InitStructure;

    USART_StructInit(&USART_InitStructure);

    RCC_APB1PeriphClockCmd(RCC_APB1Periph_USART2, ENABLE); //开启USART2时钟
    RCC_AHB1PeriphClockCmd(RCC_AHB1Periph_GPIOD, ENABLE);

    //串口中断优先级
    NVIC_InitStructure.NVIC_IRQChannel = USART2_IRQn;
    NVIC_InitStructure.NVIC_IRQChannelPreemptionPriority = NVIC_UART2_P;
    NVIC_InitStructure.NVIC_IRQChannelSubPriority = NVIC_UART2_S;
    NVIC_InitStructure.NVIC_IRQChannelCmd = ENABLE;
    NVIC_Init(&NVIC_InitStructure);

    GPIO_PinAFConfig(GPIOD, GPIO_PinSource5, GPIO_AF_USART2);
    GPIO_PinAFConfig(GPIOD, GPIO_PinSource6, GPIO_AF_USART2);

    //配置PD5作为USART2　Tx
    GPIO_InitStructure.GPIO_Pin = GPIO_Pin_5;
    GPIO_InitStructure.GPIO_Mode = GPIO_Mode_AF;
    GPIO_InitStructure.GPIO_Speed = GPIO_Speed_50MHz;
    GPIO_InitStructure.GPIO_OType = GPIO_OType_PP;
    GPIO_InitStructure.GPIO_PuPd = GPIO_PuPd_UP;
    GPIO_Init(GPIOD, &GPIO_InitStructure);
    //配置PD6作为USART2　Rx
    GPIO_InitStructure.GPIO_Pin = GPIO_Pin_6;
    GPIO_InitStructure.GPIO_Mode = GPIO_Mode_AF;
    GPIO_InitStructure.GPIO_Speed = GPIO_Speed_50MHz;
    GPIO_InitStructure.GPIO_OType = GPIO_OType_OD;
    GPIO_InitStructure.GPIO_PuPd = GPIO_PuPd_NOPULL;
    GPIO_Init(GPIOD, &GPIO_InitStructure);

    //配置USART2
    //中断被屏蔽了
    USART_InitStructure.USART_BaudRate = br_num;                                    //波特率可以通过地面站配置
    USART_InitStructure.USART_WordLength = USART_WordLength_8b;                     //8位数据
    USART_InitStructure.USART_StopBits = USART_StopBits_1;                          //在帧结尾传输1个停止位
    USART_InitStructure.USART_Parity = USART_Parity_No;                             //禁用奇偶校验
    USART_InitStructure.USART_HardwareFlowControl = USART_HardwareFlowControl_None; //硬件流控制失能
    USART_InitStructure.USART_Mode = USART_Mode_Tx | USART_Mode_Rx;                 //发送、接收使能
    //配置USART2时钟
    USART_ClockInitStruct.USART_Clock = USART_Clock_Disable;     //时钟低电平活动
    USART_ClockInitStruct.USART_CPOL = USART_CPOL_Low;           //SLCK引脚上时钟输出的极性->低电平
    USART_ClockInitStruct.USART_CPHA = USART_CPHA_2Edge;         //时钟第二个边沿进行数据捕获
    USART_ClockInitStruct.USART_LastBit = USART_LastBit_Disable; //最后一位数据的时钟脉冲不从SCLK输出

    USART_Init(USART2, &USART_InitStructure);
    USART_ClockInit(USART2, &USART_ClockInitStruct);

    //使能USART2接收中断
    USART_ITConfig(USART2, USART_IT_RXNE, ENABLE);
    //使能USART2
    USART_Cmd(USART2, ENABLE);
}
#define U2TXBUFLEN	2000
u8 TxBuffer[U2TXBUFLEN];
u16 U2TxOutAddr = 0;
u16 U2TxInAddr = 0;
void DrvUart2SendBuf(unsigned char *DataToSend, u16 data_num)
{
    u16 i;
    for (i = 0; i < data_num; i++)
    {
        TxBuffer[U2TxInAddr++] = *(DataToSend + i);
		if(U2TxInAddr >= U2TXBUFLEN)
			U2TxInAddr = 0;
    }

    if (!(USART2->CR1 & USART_CR1_TXEIE))
    {
        USART_ITConfig(USART2, USART_IT_TXE, ENABLE); //打开发送中断
    }
}
u8 U2RxDataTmp[100];
u8 U2RxInCnt = 0;
u8 U2RxoutCnt = 0;
void drvU2GetByte(u8 data)
{
	U2RxDataTmp[U2RxInCnt++] = data;
	if(U2RxInCnt >= 100)
		U2RxInCnt = 0;
	//DrvUart2SendBuf(&data,1);
}
void drvU2DataCheck(void)
{
	while(U2RxInCnt!=U2RxoutCnt)
	{
		U2GetOneByte(U2RxDataTmp[U2RxoutCnt++]);
		if(U2RxoutCnt >= 100)
			U2RxoutCnt = 0;
	}
}
void Usart2_IRQ(void)
{
    u8 com_data;

    if (USART2->SR & USART_SR_ORE) //ORE中断
    {
        com_data = USART2->DR;
    }

    //接收中断
    if (USART_GetITStatus(USART2, USART_IT_RXNE))
    {
        USART_ClearITPendingBit(USART2, USART_IT_RXNE); //清除中断标志
        com_data = USART2->DR;
		drvU2GetByte(com_data);
    }
    //发送（进入移位）中断
    if (USART_GetITStatus(USART2, USART_IT_TXE))
    {
        USART2->DR = TxBuffer[U2TxOutAddr++]; //写DR清除中断标志
		if(U2TxOutAddr >= U2TXBUFLEN)
			U2TxOutAddr = 0;
        if (U2TxOutAddr == U2TxInAddr)
        {
            USART2->CR1 &= ~USART_CR1_TXEIE; //关闭TXE（发送中断）中断
        }
    }
}

//====uart3
/////////////////////////////////////////////////////////////////////////////////////////////////////////////
void DrvUart3Init(u32 br_num)
{
    USART_InitTypeDef USART_InitStructure;
    USART_ClockInitTypeDef USART_ClockInitStruct;
    NVIC_InitTypeDef NVIC_InitStructure;
    GPIO_InitTypeDef GPIO_InitStructure;

    USART_StructInit(&USART_InitStructure);

    RCC_APB1PeriphClockCmd(RCC_APB1Periph_USART3, ENABLE); //开启USART2时钟
    RCC_AHB1PeriphClockCmd(RCC_AHB1Periph_GPIOB, ENABLE);

    //串口中断优先级
    NVIC_InitStructure.NVIC_IRQChannel = USART3_IRQn;
    NVIC_InitStructure.NVIC_IRQChannelPreemptionPriority = 2;
    NVIC_InitStructure.NVIC_IRQChannelSubPriority = 0;
    NVIC_InitStructure.NVIC_IRQChannelCmd = ENABLE;
    NVIC_Init(&NVIC_InitStructure);

    GPIO_PinAFConfig(GPIOB, GPIO_PinSource10, GPIO_AF_USART3);
    GPIO_PinAFConfig(GPIOB, GPIO_PinSource11, GPIO_AF_USART3);

    //配置PD5作为USART2　Tx
    GPIO_InitStructure.GPIO_Pin = GPIO_Pin_10;
    GPIO_InitStructure.GPIO_Mode = GPIO_Mode_AF;
    GPIO_InitStructure.GPIO_Speed = GPIO_Speed_50MHz;
    GPIO_InitStructure.GPIO_OType = GPIO_OType_PP;
    GPIO_InitStructure.GPIO_PuPd = GPIO_PuPd_UP;
    GPIO_Init(GPIOB, &GPIO_InitStructure);
    //配置PD6作为USART2　Rx
    GPIO_InitStructure.GPIO_Pin = GPIO_Pin_11;
    GPIO_InitStructure.GPIO_Mode = GPIO_Mode_AF;
    GPIO_InitStructure.GPIO_Speed = GPIO_Speed_50MHz;
    GPIO_InitStructure.GPIO_OType = GPIO_OType_OD;
    GPIO_InitStructure.GPIO_PuPd = GPIO_PuPd_NOPULL;
    GPIO_Init(GPIOB, &GPIO_InitStructure);

    //配置USART2
    //中断被屏蔽了
    USART_InitStructure.USART_BaudRate = br_num;                                    //波特率可以通过地面站配置
    USART_InitStructure.USART_WordLength = USART_WordLength_8b;                     //8位数据
    USART_InitStructure.USART_StopBits = USART_StopBits_1;                          //在帧结尾传输1个停止位
    USART_InitStructure.USART_Parity = USART_Parity_No;                             //禁用奇偶校验
    USART_InitStructure.USART_HardwareFlowControl = USART_HardwareFlowControl_None; //硬件流控制失能
    USART_InitStructure.USART_Mode = USART_Mode_Tx | USART_Mode_Rx;                 //发送、接收使能
    //配置USART2时钟
    USART_ClockInitStruct.USART_Clock = USART_Clock_Disable;     //时钟低电平活动
    USART_ClockInitStruct.USART_CPOL = USART_CPOL_Low;           //SLCK引脚上时钟输出的极性->低电平
    USART_ClockInitStruct.USART_CPHA = USART_CPHA_2Edge;         //时钟第二个边沿进行数据捕获
    USART_ClockInitStruct.USART_LastBit = USART_LastBit_Disable; //最后一位数据的时钟脉冲不从SCLK输出

    USART_Init(USART3, &USART_InitStructure);
    USART_ClockInit(USART3, &USART_ClockInitStruct);

    //使能USART2接收中断
    USART_ITConfig(USART3, USART_IT_RXNE, ENABLE);
    //使能USART2
    USART_Cmd(USART3, ENABLE);
}

u8 Tx3Buffer[256];
u8 Tx3Counter = 0;
u8 count3 = 0;
void DrvUart3SendBuf(unsigned char *DataToSend, u8 data_num)
{
    u8 i;
    for (i = 0; i < data_num; i++)
    {
        Tx3Buffer[count3++] = *(DataToSend + i);
    }
    if (!(USART3->CR1 & USART_CR1_TXEIE))
    {
        USART_ITConfig(USART3, USART_IT_TXE, ENABLE); //打开发送中断
    }
}
u8 U3RxDataTmp[100];
u8 U3RxInCnt = 0;
u8 U3RxoutCnt = 0;
void drvU3GetByte(u8 data)
{
	U3RxDataTmp[U3RxInCnt++] = data;
	if(U3RxInCnt >= 100)
		U3RxInCnt = 0;
}
void drvU3DataCheck(void)
{
	while(U3RxInCnt!=U3RxoutCnt)
	{
		U3GetOneByte(U3RxDataTmp[U3RxoutCnt++]);
		if(U3RxoutCnt >= 100)
			U3RxoutCnt = 0;
	}
}
void Usart3_IRQ(void)
{
    u8 com_data;

    if (USART3->SR & USART_SR_ORE) //ORE中断
        com_data = USART3->DR;

    //接收中断
    if (USART_GetITStatus(USART3, USART_IT_RXNE))
    {
        USART_ClearITPendingBit(USART3, USART_IT_RXNE); //清除中断标志
        com_data = USART3->DR;
		drvU3GetByte(com_data);
    }
    //发送（进入移位）中断
    if (USART_GetITStatus(USART3, USART_IT_TXE))
    {
        USART3->DR = Tx3Buffer[Tx3Counter++]; //写DR清除中断标志
        if (Tx3Counter == count3)
        {
            USART3->CR1 &= ~USART_CR1_TXEIE; //关闭TXE（发送中断）中断
        }
    }
}
/////////////////////////////////////////////////////////////////////////////////////////////////////////////
//====uart4
void DrvUart4Init(u32 br_num)
{
    USART_InitTypeDef USART_InitStructure;
    //USART_ClockInitTypeDef USART_ClockInitStruct;
    NVIC_InitTypeDef NVIC_InitStructure;
    GPIO_InitTypeDef GPIO_InitStructure;

    USART_StructInit(&USART_InitStructure);

    RCC_APB1PeriphClockCmd(RCC_APB1Periph_UART4, ENABLE); //开启USART2时钟
    RCC_AHB1PeriphClockCmd(RCC_AHB1Periph_GPIOA, ENABLE);

    //串口中断优先级
    NVIC_InitStructure.NVIC_IRQChannel = UART4_IRQn;
    NVIC_InitStructure.NVIC_IRQChannelPreemptionPriority = NVIC_UART4_P;
    NVIC_InitStructure.NVIC_IRQChannelSubPriority = NVIC_UART4_S;
    NVIC_InitStructure.NVIC_IRQChannelCmd = ENABLE;
    NVIC_Init(&NVIC_InitStructure);

    GPIO_PinAFConfig(GPIOA, GPIO_PinSource0, GPIO_AF_UART4);
    GPIO_PinAFConfig(GPIOA, GPIO_PinSource1, GPIO_AF_UART4);

    //配置PC12作为UART5　Tx
    GPIO_InitStructure.GPIO_Pin = GPIO_Pin_0;
    GPIO_InitStructure.GPIO_Mode = GPIO_Mode_AF;
    GPIO_InitStructure.GPIO_Speed = GPIO_Speed_50MHz;
    GPIO_InitStructure.GPIO_OType = GPIO_OType_PP;
    GPIO_InitStructure.GPIO_PuPd = GPIO_PuPd_UP;
    GPIO_Init(GPIOA, &GPIO_InitStructure);
    //配置PD2作为UART5　Rx
    GPIO_InitStructure.GPIO_Pin = GPIO_Pin_1;
    GPIO_InitStructure.GPIO_Mode = GPIO_Mode_AF;
    GPIO_InitStructure.GPIO_Speed = GPIO_Speed_50MHz;
    GPIO_InitStructure.GPIO_OType = GPIO_OType_OD;
    GPIO_InitStructure.GPIO_PuPd = GPIO_PuPd_NOPULL;
    GPIO_Init(GPIOA, &GPIO_InitStructure);

    //配置UART5
    //中断被屏蔽了
    USART_InitStructure.USART_BaudRate = br_num;                                    //波特率可以通过地面站配置
    USART_InitStructure.USART_WordLength = USART_WordLength_8b;                     //8位数据
    USART_InitStructure.USART_StopBits = USART_StopBits_1;                          //在帧结尾传输1个停止位
    USART_InitStructure.USART_Parity = USART_Parity_No;                             //禁用奇偶校验
    USART_InitStructure.USART_HardwareFlowControl = USART_HardwareFlowControl_None; //硬件流控制失能
    USART_InitStructure.USART_Mode = USART_Mode_Tx | USART_Mode_Rx;                 //发送、接收使能
    USART_Init(UART4, &USART_InitStructure);

    //使能UART5接收中断
    USART_ITConfig(UART4, USART_IT_RXNE, ENABLE);
    //使能USART5
    USART_Cmd(UART4, ENABLE);
}
u8 Tx4Buffer[256];
u8 Tx4Counter = 0;
u8 count4 = 0;
void DrvUart4SendBuf(unsigned char *DataToSend, u8 data_num)
{
    u8 i;
    for (i = 0; i < data_num; i++)
    {
        Tx4Buffer[count4++] = *(DataToSend + i);
    }

    if (!(UART4->CR1 & USART_CR1_TXEIE))
    {
        USART_ITConfig(UART4, USART_IT_TXE, ENABLE); //打开发送中断
    }
}
u8 U4RxDataTmp[100];
u8 U4RxInCnt = 0;
u8 U4RxoutCnt = 0;
void drvU4GetByte(u8 data)
{
	U4RxDataTmp[U4RxInCnt++] = data;
	if(U4RxInCnt >= 100)
		U4RxInCnt = 0;
}
void drvU4DataCheck(void)
{
	while(U4RxInCnt!=U4RxoutCnt)
	{
		U4GetOneByte(U4RxDataTmp[U4RxoutCnt++]);
		if(U4RxoutCnt >= 100)
			U4RxoutCnt = 0;
	}
}
void Uart4_IRQ(void)
{
    u8 com_data;

    if (UART4->SR & USART_SR_ORE) //ORE中断
    {
        com_data = UART4->DR;
    }
    //接收中断
    if (USART_GetITStatus(UART4, USART_IT_RXNE))
    {
        USART_ClearITPendingBit(UART4, USART_IT_RXNE); //清除中断标志
        com_data = UART4->DR;
        drvU4GetByte(com_data);
    }

    //发送（进入移位）中断
    if (USART_GetITStatus(UART4, USART_IT_TXE))
    {
        UART4->DR = Tx4Buffer[Tx4Counter++]; //写DR清除中断标志
        if (Tx4Counter == count4)
        {
            UART4->CR1 &= ~USART_CR1_TXEIE; //关闭TXE（发送中断）中断
        }
    }
}

//====uart5
void DrvUart5Init(u32 br_num)
{
    USART_InitTypeDef USART_InitStructure;
    //USART_ClockInitTypeDef USART_ClockInitStruct;
    NVIC_InitTypeDef NVIC_InitStructure;
    GPIO_InitTypeDef GPIO_InitStructure;

    USART_StructInit(&USART_InitStructure);

    RCC_APB1PeriphClockCmd(RCC_APB1Periph_UART5, ENABLE); //开启USART2时钟
    RCC_AHB1PeriphClockCmd(RCC_AHB1Periph_GPIOC, ENABLE);
    RCC_AHB1PeriphClockCmd(RCC_AHB1Periph_GPIOD, ENABLE);

    //串口中断优先级
    NVIC_InitStructure.NVIC_IRQChannel = UART5_IRQn;
    NVIC_InitStructure.NVIC_IRQChannelPreemptionPriority = NVIC_UART5_P;
    NVIC_InitStructure.NVIC_IRQChannelSubPriority = NVIC_UART5_S;
    NVIC_InitStructure.NVIC_IRQChannelCmd = ENABLE;
    NVIC_Init(&NVIC_InitStructure);

    GPIO_PinAFConfig(GPIOC, GPIO_PinSource12, GPIO_AF_UART5);
    GPIO_PinAFConfig(GPIOD, GPIO_PinSource2, GPIO_AF_UART5);

    //配置PC12作为UART5　Tx
    GPIO_InitStructure.GPIO_Pin = GPIO_Pin_12;
    GPIO_InitStructure.GPIO_Mode = GPIO_Mode_AF;
    GPIO_InitStructure.GPIO_Speed = GPIO_Speed_50MHz;
    GPIO_InitStructure.GPIO_OType = GPIO_OType_PP;
    GPIO_InitStructure.GPIO_PuPd = GPIO_PuPd_UP;
    GPIO_Init(GPIOC, &GPIO_InitStructure);
    //配置PD2作为UART5　Rx
    GPIO_InitStructure.GPIO_Pin = GPIO_Pin_2;
    GPIO_InitStructure.GPIO_Mode = GPIO_Mode_AF;
    GPIO_InitStructure.GPIO_Speed = GPIO_Speed_50MHz;
    GPIO_InitStructure.GPIO_OType = GPIO_OType_OD;
    GPIO_InitStructure.GPIO_PuPd = GPIO_PuPd_NOPULL;
    GPIO_Init(GPIOD, &GPIO_InitStructure);

    //配置UART5
    //中断被屏蔽了
    USART_InitStructure.USART_BaudRate = br_num;                                    //波特率可以通过地面站配置
    USART_InitStructure.USART_WordLength = USART_WordLength_8b;                     //8位数据
    USART_InitStructure.USART_StopBits = USART_StopBits_1;                          //在帧结尾传输1个停止位
    USART_InitStructure.USART_Parity = USART_Parity_No;                             //禁用奇偶校验
    USART_InitStructure.USART_HardwareFlowControl = USART_HardwareFlowControl_None; //硬件流控制失能
    USART_InitStructure.USART_Mode = USART_Mode_Tx | USART_Mode_Rx;                 //发送、接收使能
    USART_Init(UART5, &USART_InitStructure);

    //使能UART5接收中断
    USART_ITConfig(UART5, USART_IT_RXNE, ENABLE);
    //使能USART5
    USART_Cmd(UART5, ENABLE);
}
u8 Tx5Buffer[256];
u8 Tx5Counter = 0;
u8 count5 = 0;
void DrvUart5SendBuf(unsigned char *DataToSend, u8 data_num)
{
    u8 i;
    for (i = 0; i < data_num; i++)
    {
        Tx5Buffer[count5++] = *(DataToSend + i);
    }

    if (!(UART5->CR1 & USART_CR1_TXEIE))
    {
        USART_ITConfig(UART5, USART_IT_TXE, ENABLE); //打开发送中断
    }
}
u8 U5RxDataTmp[100];
u8 U5RxInCnt = 0;
u8 U5RxoutCnt = 0;
void drvU5GetByte(u8 data)
{
	U5RxDataTmp[U5RxInCnt++] = data;
	if(U5RxInCnt >= 100)
		U5RxInCnt = 0;
}
void drvU5DataCheck(void)
{
	while(U5RxInCnt!=U5RxoutCnt)
	{
		U5GetOneByte(U5RxDataTmp[U5RxoutCnt++]);
		if(U5RxoutCnt >= 100)
			U5RxoutCnt = 0;
	}
}
void Uart5_IRQ(void)
{
    u8 com_data;
	
    if (UART5->SR & USART_SR_ORE) //ORE中断
    {
        com_data = UART5->DR;
    }
    //接收中断
    if (USART_GetITStatus(UART5, USART_IT_RXNE))
    {
        USART_ClearITPendingBit(UART5, USART_IT_RXNE); //清除中断标志   
        com_data = UART5->DR;
        drvU5GetByte(com_data);
    }

    //发送（进入移位）中断
    if (USART_GetITStatus(UART5, USART_IT_TXE))
    {
        UART5->DR = Tx5Buffer[Tx5Counter++]; //写DR清除中断标志
        if (Tx5Counter == count5)
        {
            UART5->CR1 &= ~USART_CR1_TXEIE; //关闭TXE（发送中断）中断
        }
    }
}



void DrvUartDataCheck(void)
{
	drvU1DataCheck();
	drvU2DataCheck();
	drvU3DataCheck();
	drvU4DataCheck();
	drvU5DataCheck();
}
/******************* (C) COPYRIGHT 2014 ANO TECH *****END OF FILE************/
