JiaXinTang-xiang/nav_n10/firmware_fc/ANO_LX_FC_ROS/FcSrc/Ano_Scheduler.c

/******************** (C) COPYRIGHT 2017 ANO Tech ********************************
 * 作者    ：匿名科创
 * 官网    ：www.anotc.com
 * 淘宝    ：anotc.taobao.com
 * 技术Q群 ：190169595
 * 描述    ：任务调度
**********************************************************************************/
#include "Ano_Scheduler.h"
#include "User_Task.h"
#include "User_Task1.h"
#include "ANO_DT_LX.h"
#include "AnoDTRasp.h"
#include "Height_PID_AutoCtrl.h"
#include "Pos_PID_AutoCtrl.h"
#include "User_Parameter.h"
#include "Drv_AnoOf.h"
#include "get_data.h"
#include "my_uart.h"
#include "Drv_Uart.h"
//////////////////////////////////////////////////////////////////////
//用户程序调度器
//////////////////////////////////////////////////////////////////////

static void Loop_1000Hz(void) //1ms执行一次
{
	//////////////////////////////////////////////////////////////////////
	LxF1Send_9(	rosData.tacc[0],rosData.tacc[1],rosData.tacc[2],
				-rosData.loc[0],-rosData.loc[1],rosData.loc[2],rosData.acc[1],ano_of.of1_dx,ano_of.of1_dy,ano_of.of_alt_cm);
	 get_data();//获取数据
	
//		UART1_Send(-rosData.loc[0],-rosData.loc[1],rosData.loc[2]);	
//	UART1_Send(1,2,3);
//	UART1_send_data();

	//LxF1SendSpeed(rosData.acc[0],rosData.acc[1],rosData.acc[2],rosData.yaw);
	
	//////////////////////////////////////////////////////////////////////
}

static void Loop_500Hz(void) //2ms执行一次
{
	//////////////////////////////////////////////////////////////////////
	
	//////////////////////////////////////////////////////////////////////
}

static void Loop_200Hz(void) //5ms执行一次
{
	//////////////////////////////////////////////////////////////////////

	//////////////////////////////////////////////////////////////////////
}

static void Loop_100Hz(void) //10ms执行一次
{
	//////////////////////////////////////////////////////////////////////

	//////////////////////////////////////////////////////////////////////
}

static void Loop_50Hz(void) //20ms执行一次
{
	//////////////////////////////////////////////////////////////////////
	
	/*高度PID控制函数*/
  Fc_Height_PID(20,height);
	/*位置PID控制函数*/
//	FC_loc_PID(20);
	 PID1();
	
	/*任务代码*/
	UserTask_OneKeyCmd();
	UserTask_OneKeyCmd1();
	//////////////////////////////////////////////////////////////////////
}

static void Loop_20Hz(void) //50ms执行一次
{
	//////////////////////////////////////////////////////////////////////

	//////////////////////////////////////////////////////////////////////
}

static void Loop_2Hz(void) //500ms执行一次
{
	/*关机指令*/
	//AnoPTv7Send_ShutDown();
	/*重启指令*/
	//AnoPTv7Send_Restart();
	
	Ano_Parame_Write_task(500);
}
//////////////////////////////////////////////////////////////////////
//调度器初始化
//////////////////////////////////////////////////////////////////////
//系统任务配置，创建不同执行频率的“线程”
static sched_task_t sched_tasks[] =
	{
		{Loop_1000Hz, 1000, 0, 0},
		{Loop_500Hz, 500, 0, 0},
		{Loop_200Hz, 200, 0, 0},
		{Loop_100Hz, 100, 0, 0},
		{Loop_50Hz, 50, 0, 0},
		{Loop_20Hz, 20, 0, 0},
		{Loop_2Hz, 2, 0, 0},
};
//根据数组长度，判断线程数量
#define TASK_NUM (sizeof(sched_tasks) / sizeof(sched_task_t))

void Scheduler_Setup(void)
{
	uint8_t index = 0;
	//初始化任务表
	for (index = 0; index < TASK_NUM; index++)
	{
		//计算每个任务的延时周期数
		sched_tasks[index].interval_ticks = TICK_PER_SECOND / sched_tasks[index].rate_hz;
		//最短周期为1，也就是1ms
		if (sched_tasks[index].interval_ticks < 1)
		{
			sched_tasks[index].interval_ticks = 1;
		}
	}
}
//这个函数放到main函数的while(1)中，不停判断是否有线程应该执行
void Scheduler_Run(void)
{
	uint8_t index = 0;
	//循环判断所有线程，是否应该执行

	for (index = 0; index < TASK_NUM; index++)
	{
		//获取系统当前时间，单位MS
		uint32_t tnow = GetSysRunTimeMs();
		//进行判断，如果当前时间减去上一次执行的时间，大于等于该线程的执行周期，则执行线程
		if (tnow - sched_tasks[index].last_run >= sched_tasks[index].interval_ticks)
		{

			//更新线程的执行时间，用于下一次判断
			sched_tasks[index].last_run = tnow;
			//执行线程函数，使用的是函数指针
			sched_tasks[index].task_func();
		}
	}
}

/******************* (C) COPYRIGHT 2014 ANO TECH *****END OF FILE************/
