JiaXinTang-xiang/nav_n10/Telemetry framework/boards/drv_can.h

#ifndef DRV_CAN_H
#define DRV_CAN_H

/* Includes ------------------------------------------------------------------*/

#include "stm32f4xx_hal.h"
#include "can.h"
#include <string.h>
#include <stdbool.h>

/* Exported macros -----------------------------------------------------------*/

/* Exported types ------------------------------------------------------------*/

/**
 * @brief CAN接收的信息结构体
 *
 */
struct Struct_CAN_Rx_Buffer
{
    CAN_RxHeaderTypeDef Header;
    uint8_t Data[8];
};

/**
 * @brief CAN通信接收回调函数数据类型
 *
 */
typedef void (*CAN_Call_Back)(Struct_CAN_Rx_Buffer *);

/**
 * @brief CAN通信处理结构体
 *
 */
struct Struct_CAN_Manage_Object
{
    CAN_HandleTypeDef *CAN_Handler;
    Struct_CAN_Rx_Buffer Rx_Buffer;
    CAN_Call_Back Callback_Function;
};

/* Exported variables ---------------------------------------------------------*/

extern bool init_finished;

extern CAN_HandleTypeDef hcan1;
extern CAN_HandleTypeDef hcan2;

extern Struct_CAN_Manage_Object CAN1_Manage_Object;
extern Struct_CAN_Manage_Object CAN2_Manage_Object;

extern uint8_t CAN1_0x1fe_Tx_Data[];
extern uint8_t CAN1_0x1ff_Tx_Data[];
extern uint8_t CAN1_0x200_Tx_Data[];
extern uint8_t CAN1_0x2fe_Tx_Data[];
extern uint8_t CAN1_0x2ff_Tx_Data[];
extern uint8_t CAN1_0x3fe_Tx_Data[];
extern uint8_t CAN1_0x4fe_Tx_Data[];

extern uint8_t CAN2_0x1fe_Tx_Data[];
extern uint8_t CAN2_0x1ff_Tx_Data[];
extern uint8_t CAN2_0x200_Tx_Data[];
extern uint8_t CAN2_0x2fe_Tx_Data[];
extern uint8_t CAN2_0x2ff_Tx_Data[];
extern uint8_t CAN2_0x3fe_Tx_Data[];
extern uint8_t CAN2_0x4fe_Tx_Data[];

extern uint8_t CAN_Supercap_Tx_Data[];

/* Exported function declarations ---------------------------------------------*/

void CAN_Init(CAN_HandleTypeDef *hcan, CAN_Call_Back Callback_Function);

uint8_t CAN_Send_Data(CAN_HandleTypeDef *hcan, uint16_t ID, uint8_t *Data, uint16_t Length);

void TIM_1ms_CAN_PeriodElapsedCallback();

#endif

/************************ COPYRIGHT(C) USTC-ROBOWALKER **************************/
