JiaXinTang-xiang/nav_n10/Telemetry framework/Appliaction/EDC_task.c

#include "EDC_task.h"
/*
	EDC Task（EDC = Electronic Design Contest）电赛任务  
	
                     _ooOoo_
                    o8888888o
                    88" . "88    
                    (| -_- |)
                     O\ = /O    
                 ____/`---'\____
               .   ' \\| |// `.
                / \\||| : |||// \
              / _||||| -:- |||||- \
                | | \\\ - /// | |
              | \_| ''\---/'' | |
               \ .-\__ `-` ___/-. /
            ___`. .' /--.--\ `. . __
         ."" '< `.___\_<|>_/___.' >'"".
        | | : `- \`.;`\ _ /`;.`/ - ` : | |
          \ \ `-. \_ __\ /__ _/ .-` / /
  ======`-.____`-.___\_____/___.-`____.-'======
                     `=---='
 
  .......................佛曰........................
                    南无阿弥陀佛
                  bug 退散，永无蓝屏
 */
