JiaXinTang-xiang/nav_n10/firmware_fc/ANO_LX_FC_ROS/DriversBsp/Drv_AnoOf.h

#ifndef __DRV_ANO_OF_H
#define __DRV_ANO_OF_H

//==引用
#include "SysConfig.h"

//==定义/声明

typedef struct
{
	//
	u8 of_update_cnt;  //光流数据更新计数。
	u8 alt_update_cnt; //高度数据更新计数。
	//
	u8 link_sta; //连接状态：0，未连接。1，已连接。
	u8 work_sta; //工作状态：0，异常。1，正常
	//
	u8 of_quality;
	//
	u8 of0_sta;
	s8 of0_dx;
	s8 of0_dy;
	//
	u8 of1_sta;
	s16 of1_dx;
	s16 of1_dy;
	//
	u8 of2_sta;
	s16 of2_dx;
	s16 of2_dy;
	s16 of2_dx_fix;
	s16 of2_dy_fix;
	s16 intergral_x;
	s16 intergral_y;
	//
	u32 of_alt_cm;
	//
	float quaternion[4];
	//
	s16 acc_data_x;
	s16 acc_data_y;
	s16 acc_data_z;
	s16 gyr_data_x;
	s16 gyr_data_y;
	s16 gyr_data_z;

} _ano_of_st;

//飞控状态

//==数据声明
extern _ano_of_st ano_of;
//==函数声明
//static
static void AnoOF_DataAnl(uint8_t *data_buf, uint8_t num);

void AnoOF_GetOneByteChoose(uint8_t data);

//光流v4
void AnoOF_GetOneByte(uint8_t data);
void AnoOF_Check_State(float dT_s);

/******************光流v3*************************************/
void AnoOF_GetOneByte_v3(uint8_t data);
void AnoOF_DataAnl_v3(uint8_t *data_buf,uint8_t num);

#endif
