JiaXinTang-xiang/nav_n10/example/annrosdt/anorosdt_ws/src/anorosdt/src/anoros_dt.cpp

#include "anoros_dt.h"
#include "Quaternion_Solution.h"

//创建实例
AnoPub anoPub;
AnoSub anoSub;

uint8_t read_buf[2048];

Vel_Pos_Data PosData;
Send_Data SendData;

/*
功能：主函数，ROS初始化，通过AnoRos_DT类创建DT_Control对象并自动调用构造函数初始化
*/
int main(int argc, char  *argv[])
{
    setlocale(LC_ALL,"");
    ros::init(argc, argv, "AnoRos_DT"); //ROS初始化，并设置节点名称
    AnoRos_DT anoRos_DT;
		anoRos_DT.Control();//循环执行数据采集和发布话题等操作
    return 0;
}


/*
功能：通过串口读取并逐帧校验下位机发送过来的数据
*/
bool AnoRos_DT::Get_Sensor_Data_NOW()
{	
  //串口数据解析：IMU数据、应答返回数据等
  int _cnt=Stm32_Serial.available();
  if(_cnt!=0)
  {
      Stm32_Serial.read(read_buf,_cnt);
      for(int16_t i=0;i<_cnt;i++)
      {
        if(AnoPTv7RecvOneByte(read_buf[i]))
        {
        	return true;
        }
      }
  }
  return false;
}

void AnoRos_DT::Control()
{
	ros::Rate loop_rate(200); // 设置循环频率  
	while(ros::ok())
	{
		if (true == Get_Sensor_Data_NOW())//串口获取数据
		{
			//发送数据到下位机
			AnoDTRaspRunTask1Ms();
			anoPub.pubMsgImu();
		anoPub.pubMsgGps();
		anoPub.pubMsgMag();
		anoPub.pubMsgOF();
		anoPub.pubMsgTmp();
		anoPub.pubMsgAlt();
		anoPub.pubMsgRC();
		anoPub.pubMsgUserData();
		anoPub.pubMsgOdom();
		}
		

		ros::spinOnce();//监听反馈函数
 		loop_rate.sleep();//执行循环
	}
	//ros::spin();//循环等待回调函数
}
/*
功能：构造函数，只执行一次，用于初始化
*/
AnoRos_DT::AnoRos_DT():Sampling_Time(0)
{
	//清除数据
	memset(&anoMsgImu, 		0, sizeof(anoMsgImu));
	memset(&anoMsgMag, 		0, sizeof(anoMsgMag));
	memset(&anoMsgImuSpd, 0, sizeof(anoMsgImuSpd));
	memset(&anoMsgOF,			0, sizeof(anoMsgOF));
	memset(&anoMsgGPS,		0, sizeof(anoMsgGPS));

	cmdVel.sendFalg = 0;

	anoPub.readSettings_Pub();
	anoPub.anoPubCreate_Init();
	anoSub.readSettings_Sub();
	anoSub.anoSubCreate_Init();

	//串口初始化
	Serial_Init();
}

/*
功能：析构函数，只执行一次，当对象结束其生命周期时系统会调用这个函数
*/
AnoRos_DT::~AnoRos_DT()
{
	Stm32_Serial.close();//关闭串口
}
