JiaXinTang-xiang/nav_n10/example/ros2-stm32-autonomous-robot/ros2_ws/robot_navigation/config/navigation_v1.yaml

controller_server:
  ros__parameters:
    use_sim_time: false
    controller_frequency: 20.0
    odom_topic: /odom
    min_x_velocity_threshold: 0.001
    min_y_velocity_threshold: 0.5
    min_theta_velocity_threshold: 0.001
    failure_tolerance: 0.3
    progress_checker_plugin: progress_checker
    goal_checker_plugins: [general_goal_checker]
    controller_plugins: [FollowPath]

    progress_checker:
      plugin: nav2_controller::SimpleProgressChecker
      required_movement_radius: 0.05
      # Native controller progress timeout; unchanged from accepted navigation.
      movement_time_allowance: 30.0
    general_goal_checker:
      plugin: nav2_controller::SimpleGoalChecker
      stateful: true
      xy_goal_tolerance: 0.12
      yaw_goal_tolerance: 0.15
    FollowPath:
      plugin: dwb_core::DWBLocalPlanner
      # Keep the local scoring target on the current leg of a thin-wall turn.
      # Real thin-wall test accepted 2026-09-13; previous Humble default: 2.0 m.
      forward_prune_distance: 0.4
      debug_trajectory_details: false
      min_vel_x: 0.0
      min_vel_y: 0.0
      max_vel_x: 0.20
      max_vel_y: 0.0
      max_vel_theta: 0.60
      min_speed_xy: 0.0
      max_speed_xy: 0.20
      min_speed_theta: 0.0
      acc_lim_x: 0.30
      acc_lim_y: 0.0
      acc_lim_theta: 0.80
      decel_lim_x: -0.50
      decel_lim_y: 0.0
      decel_lim_theta: -1.00
      vx_samples: 10
      vy_samples: 1
      vtheta_samples: 20
      sim_time: 1.5
      linear_granularity: 0.025
      angular_granularity: 0.025
      # Cartographer map -> odom is scan-timed; observed loaded-host lag is
      # occasionally 0.31-0.54 s.
      transform_tolerance: 0.7
      xy_goal_tolerance: 0.12
      trans_stopped_velocity: 0.05
      short_circuit_trajectory_evaluation: true
      stateful: true
      critics: [RotateToGoal, Oscillation, BaseObstacle, GoalAlign, PathAlign, PathDist, GoalDist]
      BaseObstacle.scale: 0.02
      PathAlign.scale: 32.0
      PathAlign.forward_point_distance: 0.10
      GoalAlign.scale: 24.0
      GoalAlign.forward_point_distance: 0.10
      PathDist.scale: 32.0
      GoalDist.scale: 24.0
      RotateToGoal.scale: 32.0
      RotateToGoal.slowing_factor: 5.0
      RotateToGoal.lookahead_time: -1.0

local_costmap:
  local_costmap:
    ros__parameters:
      use_sim_time: false
      global_frame: odom
      robot_base_frame: base_link
      footprint: "[[0.140, 0.080], [0.140, -0.080], [-0.070, -0.080], [-0.070, 0.080]]"
      footprint_padding: 0.01
      resolution: 0.05
      width: 5
      height: 5
      update_frequency: 5.0
      publish_frequency: 2.0
      transform_tolerance: 0.7
      track_unknown_space: false
      rolling_window: true
      always_send_full_costmap: true
      plugins: [obstacle_layer, inflation_layer]
      obstacle_layer:
        plugin: nav2_costmap_2d::ObstacleLayer
        enabled: true
        observation_sources: scan
        scan:
          topic: /scan
          data_type: LaserScan
          max_obstacle_height: 2.0
          clearing: true
          marking: true
          obstacle_min_range: 0.15
          obstacle_max_range: 12.0
          raytrace_min_range: 0.15
          raytrace_max_range: 12.0
      inflation_layer:
        plugin: nav2_costmap_2d::InflationLayer
        enabled: true
        inflation_radius: 0.25
        cost_scaling_factor: 5.0

planner_server:
  ros__parameters:
    use_sim_time: false
    expected_planner_frequency: 1.0
    planner_plugins: [GridBased]
    GridBased:
      plugin: nav2_navfn_planner/NavfnPlanner
      tolerance: 0.10
      use_astar: false
      allow_unknown: false
      use_final_approach_orientation: false

global_costmap:
  global_costmap:
    ros__parameters:
      use_sim_time: false
      global_frame: map
      robot_base_frame: base_link
      footprint: "[[0.140, 0.080], [0.140, -0.080], [-0.070, -0.080], [-0.070, 0.080]]"
      footprint_padding: 0.01
      resolution: 0.05
      update_frequency: 2.0
      publish_frequency: 1.0
      transform_tolerance: 0.7
      track_unknown_space: true
      rolling_window: false
      always_send_full_costmap: true
      plugins: [static_layer, obstacle_layer, inflation_layer]
      static_layer:
        plugin: nav2_costmap_2d::StaticLayer
        map_topic: /map
        map_subscribe_transient_local: true
        subscribe_to_updates: false
      obstacle_layer:
        plugin: nav2_costmap_2d::ObstacleLayer
        enabled: true
        observation_sources: scan
        scan:
          topic: /scan
          data_type: LaserScan
          max_obstacle_height: 2.0
          clearing: true
          marking: true
          obstacle_min_range: 0.15
          obstacle_max_range: 12.0
          raytrace_min_range: 0.15
          raytrace_max_range: 12.0
      inflation_layer:
        plugin: nav2_costmap_2d::InflationLayer
        enabled: true
        inflation_radius: 0.25
        cost_scaling_factor: 5.0

behavior_server:
  ros__parameters:
    use_sim_time: false
    local_frame: odom
    global_frame: map
    robot_base_frame: base_link
    transform_tolerance: 0.7
    costmap_topic: local_costmap/costmap_raw
    footprint_topic: local_costmap/published_footprint
    cycle_frequency: 10.0
    simulate_ahead_time: 2.0
    max_rotational_vel: 0.60
    min_rotational_vel: 0.20
    rotational_acc_lim: 0.80
    behavior_plugins: [wait]
    wait:
      plugin: nav2_behaviors/Wait

bt_navigator:
  ros__parameters:
    use_sim_time: false
    global_frame: map
    robot_base_frame: base_link
    odom_topic: /odom
    bt_loop_duration: 10
    # BT action acknowledgement timeout in milliseconds, not a motion watchdog.
    # Real host aborted a valid plan on the previous 20 ms acknowledgement budget.
    default_server_timeout: 1000
    wait_for_service_timeout: 1000
    plugin_lib_names:
      - nav2_compute_path_to_pose_action_bt_node
      - nav2_compute_path_through_poses_action_bt_node
      - nav2_smooth_path_action_bt_node
      - nav2_follow_path_action_bt_node
      - nav2_spin_action_bt_node
      - nav2_wait_action_bt_node
      - nav2_assisted_teleop_action_bt_node
      - nav2_back_up_action_bt_node
      - nav2_drive_on_heading_bt_node
      - nav2_clear_costmap_service_bt_node
      - nav2_is_stuck_condition_bt_node
      - nav2_goal_reached_condition_bt_node
      - nav2_goal_updated_condition_bt_node
      - nav2_globally_updated_goal_condition_bt_node
      - nav2_is_path_valid_condition_bt_node
      - nav2_initial_pose_received_condition_bt_node
      - nav2_reinitialize_global_localization_service_bt_node
      - nav2_rate_controller_bt_node
      - nav2_distance_controller_bt_node
      - nav2_speed_controller_bt_node
      - nav2_truncate_path_action_bt_node
      - nav2_truncate_path_local_action_bt_node
      - nav2_goal_updater_node_bt_node
      - nav2_recovery_node_bt_node
      - nav2_pipeline_sequence_bt_node
      - nav2_round_robin_node_bt_node
      - nav2_transform_available_condition_bt_node
      - nav2_time_expired_condition_bt_node
      - nav2_path_expiring_timer_condition
      - nav2_distance_traveled_condition_bt_node
      - nav2_single_trigger_bt_node
      - nav2_goal_updated_controller_bt_node
      - nav2_is_battery_low_condition_bt_node
      - nav2_navigate_through_poses_action_bt_node
      - nav2_navigate_to_pose_action_bt_node
      - nav2_remove_passed_goals_action_bt_node
      - nav2_planner_selector_bt_node
      - nav2_controller_selector_bt_node
      - nav2_goal_checker_selector_bt_node
      - nav2_controller_cancel_bt_node
      - nav2_path_longer_on_approach_bt_node
      - nav2_wait_cancel_bt_node
      - nav2_spin_cancel_bt_node
      - nav2_back_up_cancel_bt_node
      - nav2_assisted_teleop_cancel_bt_node
      - nav2_drive_on_heading_cancel_bt_node
      - nav2_is_battery_charging_condition_bt_node

navigation_safety_gate:
  ros__parameters:
    goal_topic: /goal_pose
    visualized_plan_topic: /plan
    navigation_action: /navigate_to_pose
    localization_timeout_ms: 700
    input_cmd_vel_topic: /cmd_vel_nav
    cmd_vel_topic: /cmd_vel
    input_cmd_timeout_ms: 250
    max_linear_speed_mps: 0.20
    max_angular_speed_radps: 1.50
    scan_timeout_ms: 400
    bridge_timeout_ms: 300
    scan_topic: /scan
    bridge_status_topic: /stm32/status
    arm_service: /robot_stm32_bridge/arm
    disarm_service: /robot_stm32_bridge/disarm
