JiaXinTang-xiang/nav_n10/example/ros2-stm32-autonomous-robot/ros2_ws/robot_stm32_bridge/config/drivetrain_commissioning.yaml

robot_stm32_bridge:
  ros__parameters:
    can_interface: can3
    cmd_vel_topic: /cmd_vel
    imu_frame_id: imu_link
    odom_topic: /odom
    odom_frame_id: odom
    base_frame_id: base_link
    # Independent measured commissioning scales; do not average them.
    left_meters_per_count: 0.0001362305
    right_meters_per_count: 0.0001363976
    track_width_m: 0.125
    # Host-side deadline. This is intentionally well inside the STM32 250 ms timeout.
    command_timeout_ms: 100
    status_timeout_ms: 350
    reconnect_period_ms: 1000
    unsupported_twist_epsilon: 1.0e-9

straight_obstacle_stop_demo:
  ros__parameters:
    # Commissioning defaults only; these are not robot safety specifications.
    forward_speed_mps: 0.30
    stop_distance_m: 0.60
    front_sector_deg: 30.0
    # base_link -> laser_frame yaw is pi, so robot-forward is 180 degrees in /scan.
    front_center_deg: 180.0
    scan_timeout_ms: 400
    bridge_timeout_ms: 300
    scan_topic: /scan
    cmd_vel_topic: /cmd_vel
    bridge_status_topic: /stm32/status
    arm_service: /robot_stm32_bridge/arm
    disarm_service: /robot_stm32_bridge/disarm
