JiaXinTang-xiang/nav_n10/Telemetry framework/boards/tool_delay.c

#include "tool_delay.h"

static uint8_t fac_us = 0;
static uint32_t fac_ms = 0;

void delay_init(void)
{
    fac_us = SystemCoreClock / 1000000;
    fac_ms = SystemCoreClock / 1000;

    /* 使能 DWT 周期计数器 (供 delay_ns 使用) */
    CoreDebug->DEMCR |= CoreDebug_DEMCR_TRCENA_Msk;
    DWT->CYCCNT = 0;
    DWT->CTRL |= DWT_CTRL_CYCCNTENA_Msk;
}

void delay_us(uint16_t nus)
{
    uint32_t ticks = 0;
    uint32_t told = 0;
    uint32_t tnow = 0;
    uint32_t tcnt = 0;
    uint32_t reload = 0;
    reload = SysTick->LOAD;
    ticks = nus * fac_us;
    told = SysTick->VAL;
    while (1)
    {
        tnow = SysTick->VAL;
        if (tnow != told)
        {
            if (tnow < told)
            {
                tcnt += told - tnow;
            }
            else
            {
                tcnt += reload - tnow + told;
            }
            told = tnow;
            if (tcnt >= ticks)
            {
                break;
            }
        }
    }
}

void delay_ms(uint16_t nms)
{
    uint32_t ticks = 0;
    uint32_t told = 0;
    uint32_t tnow = 0;
    uint32_t tcnt = 0;
    uint32_t reload = 0;
    reload = SysTick->LOAD;
    ticks = nms * fac_ms;
    told = SysTick->VAL;
    while (1)
    {
        tnow = SysTick->VAL;
        if (tnow != told)
        {
            if (tnow < told)
            {
                tcnt += told - tnow;
            }
            else
            {
                tcnt += reload - tnow + told;
            }
            told = tnow;
            if (tcnt >= ticks)
            {
                break;
            }
        }
    }
}

/**
 * @brief  纳秒级延时 (使用 DWT 周期计数器)
 * @param  nns  纳秒数 (1 ~ 1,000,000,000)
 * @note   最小分辨率取决于 MCU 主频, 168MHz 下约 6ns
 *         调用前需先执行 delay_init()
 */
void delay_ns(uint32_t nns)
{
    uint32_t cycles = (SystemCoreClock / 1000000) * nns / 1000;
    uint32_t start  = DWT->CYCCNT;
    while ((DWT->CYCCNT - start) < cycles);
}
