JiaXinTang-xiang/nav_n10/Telemetry framework/boards/tool_delay.h

#ifndef TOOL_DELAY_H
#define TOOL_DELAY_H
#include "main.h"

extern void delay_init(void);
extern void delay_us(uint16_t nus);
extern void delay_ms(uint16_t nms);
extern void delay_ns(uint32_t nns);
#endif
