JiaXinTang-xiang/nav_n10/(commit log)

2026-10-01 初始导入项目源码
2026-10-02 1.0底盘完成
2026-10-02 上危机改
2026-10-02 fix: anoros_dt 双重shutdown假死 + bringup 脚本卡死/无nohup
    - anoros_dt_node.py: 移除 SIGTERM 信号处理器里重复的 rclpy.shutdown()
    (触发 'Context must be initialized' 崩溃→节点假死不发数据)，改为
    finally 里用 rclpy.ok() 守卫
    - robot_bringup.sh: 节点改 nohup+日志落盘、显式 export ROS_DOMAIN_ID/
    ROS_LOCALHOST_ONLY、ros2 topic list 加 timeout、去掉 daemon 重启竞态
    [anoros_dt_node.py]
2026-10-02 revert: 回退默认 FastDDS(热点组播正常) + daemon 改 pkill 强杀避免 RMW 切换卡死
2026-10-03 fix: nav2.rviz Humble 插件类名(rviz_default_plugins/Grid, 删掉过时 View 面板)
2026-10-04 底盘2.0
2026-10-04 把 example/ 下的参考项目从子模块改为普通目录
    example/ 下 5 个子目录此前被记录为 gitlink（mode 160000），
    但仓库没有 .gitmodules，远程仓库里只有指针、没有文件内容。
    现全部改为正常追踪（1999 个文件），并移除 example/annrosdt
    里 4 个空的遗留子模块指针。
    编译产物仍由 .gitignore 排除：build/ install/ log/ devel/、
    *.a *.so *.elf *.hex *.bin *.map 等。
    [BOM_LEAP_CAM.xlsx, BOM_LEAP_ROS.xlsx, LEAP_CAM.epro, LEAP_ROS.epro, base_link.STL, configuration_file_resolver.h, imu_Link.STL, lidar_Link.STL]
2026-10-05 底盘3.0
2026-10-06 建图1.0
2026-10-07 建图2.0
    [BOM_LEAP_CAM.xlsx, BOM_LEAP_ROS.xlsx, LEAP_CAM.epro, LEAP_ROS.epro, 物料清单.xls]
2026-10-08 导航1.0
