JiaXinTang-xiang/nav_n10/(notices)

Notices in the files:
Telemetry framework/Core/Src/main.c:
Copyright (c) 2025 STMicroelectronics.
All rights reserved.
This software is licensed under terms that can be found in the LICENSE file
Telemetry framework/Core/Inc/main.h:
Copyright (c) 2026 STMicroelectronics.
